hydrogeologger/hardware-datalogger/README.md

# Datalogger Version 3.X

Project was developed in Altium.

### Physical Dimensions (Max)
* Primary: 24cm x 18cm
* Secondary: 24cm x 13cm
