hydrogeologger/hardware-datalogger/doc/rpi-bpim2zero-pinout.xlsx

 | BPI M2 Zero |  | RPI |  |  |  | RPI |  | BPI M2 Zero
Usage |  | GPIO | GPIO/BCM | Desc | Physical Pin |  | Desc | GPIO/BCM | GPIO |  | Usage
 | 3v3 |  | 3v3 |  | 1 | 2 | 5v |  | 5v
GPIO | TWI0-SDA | PA12 | 2 | I2C1 SDA | 3 | 4 | 5v |  | 5v
GPIO | TWI0-SCK | PA11 | 3 | I2C1 SCL | 5 | 6 | GND |  | GND
Switch | PWM | PA6 | 4 | GPCKL0 | 7 | 8 | UART0 (TX) | 14 | PA13 | UART3 (TX) | GPIO/TX
 | GND |  | GND |  | 9 | 10 | UART0 (RX) | 15 | PA14 | UART3 (RX) | GPIO/RX
GPIO | UART2 (RX) | PA1 | 17 |  | 11 | 12 |  | 18 | PA16 | UART3 (CTS) | GPIO
MCU Reset | UART2 (TX) | PA0 | 27 |  | 13 | 14 | GND |  | GND
Switch | UART2 (CTS) | PA3 | 22 |  | 15 | 16 |  | 23 | PA15 | UART3 (RTS) | Switch
 | 3v3 |  | 3v3 |  | 17 | 18 |  | 24 | PC4 |  | Switch
GPIO | SPI0 (MOSI) | PC0 | 10 | SPI0 MOSI | 19 | 20 | GND |  | GND
GPIO | SPI0 (MISO) | PC1 | 9 | SPI0 MISO | 21 | 22 |  | 25 | PA2 | UART2 (RTS) | Switch
GPIO | SPI0-CLK | PC2 | 11 | SPI0 SCLK | 23 | 24 | SPI0 CE0 | 8 | PC3 | SPI0-CS | GPIO
 | GND |  | GND |  | 25 | 26 | SPI0 CE1 | 7 | PC7 |  | GPIO
-- | TWI1-SDA | PA19 | 0 | EEPROM SDA | 27 | 28 | EEPROM SCL | 1 | PA18 | TWI1-SCK | --
Switch |  | PA7 | 5 |  | 29 | 30 | GND |  | GND
Switch |  | PA8 | 6 |  | 31 | 32 | PWM0 | 12 | PL2-S-EINT2 |  | GPIO
GPIO/SOFT Rx |  | PA9 | 13 | PWM1 | 33 | 34 | GND |  | GND
GPIO |  | PA10 | 19 | PCM FS | 35 | 36 |  | 16 | PL4 |  | GPIO/SOFT Tx
Switch |  | PA17 | 26 |  | 37 | 38 | PCM DIN | 20 | PA21 |  | GPIO
 | GND |  | GND |  | 39 | 40 | PCM DOUT | 21 | PA20 |  | GPIO
