hydrogeologger/hardware-datalogger/Support/Phoenix Plug Cost.xlsx

1869279 8 way phoenix 5.08 pitch angled SMKDSN |  |  | 7.6/6.6
5mm Pitch (14 AWG) | Mouser ($AUD, 50 pack, per unit) | Digikey ($AUD, 50 pack, per unit price) | RS ($AUD, 50 pack, per unit price)
1721029 - 2-Position-2L
1703895 - 4-Position-2L
5.08mm Pitch (14 AWG)
1721728 - 2-Position-2L
1889987 - 4-Position-2L
1870909 - 8-Position-2L
MKKDSN 5.08 Pitch 1.5mm wire cross
1726040 - 2 pos
1726163 - 4 Pos
1726176 - 5 Pos
1726189 - 6 Pos
1726202 - 8 Pos
1870271 - 10 Pos
1729597 - 12 Pos
