hydrogeologger/hardware-datalogger/Schematic.pdf

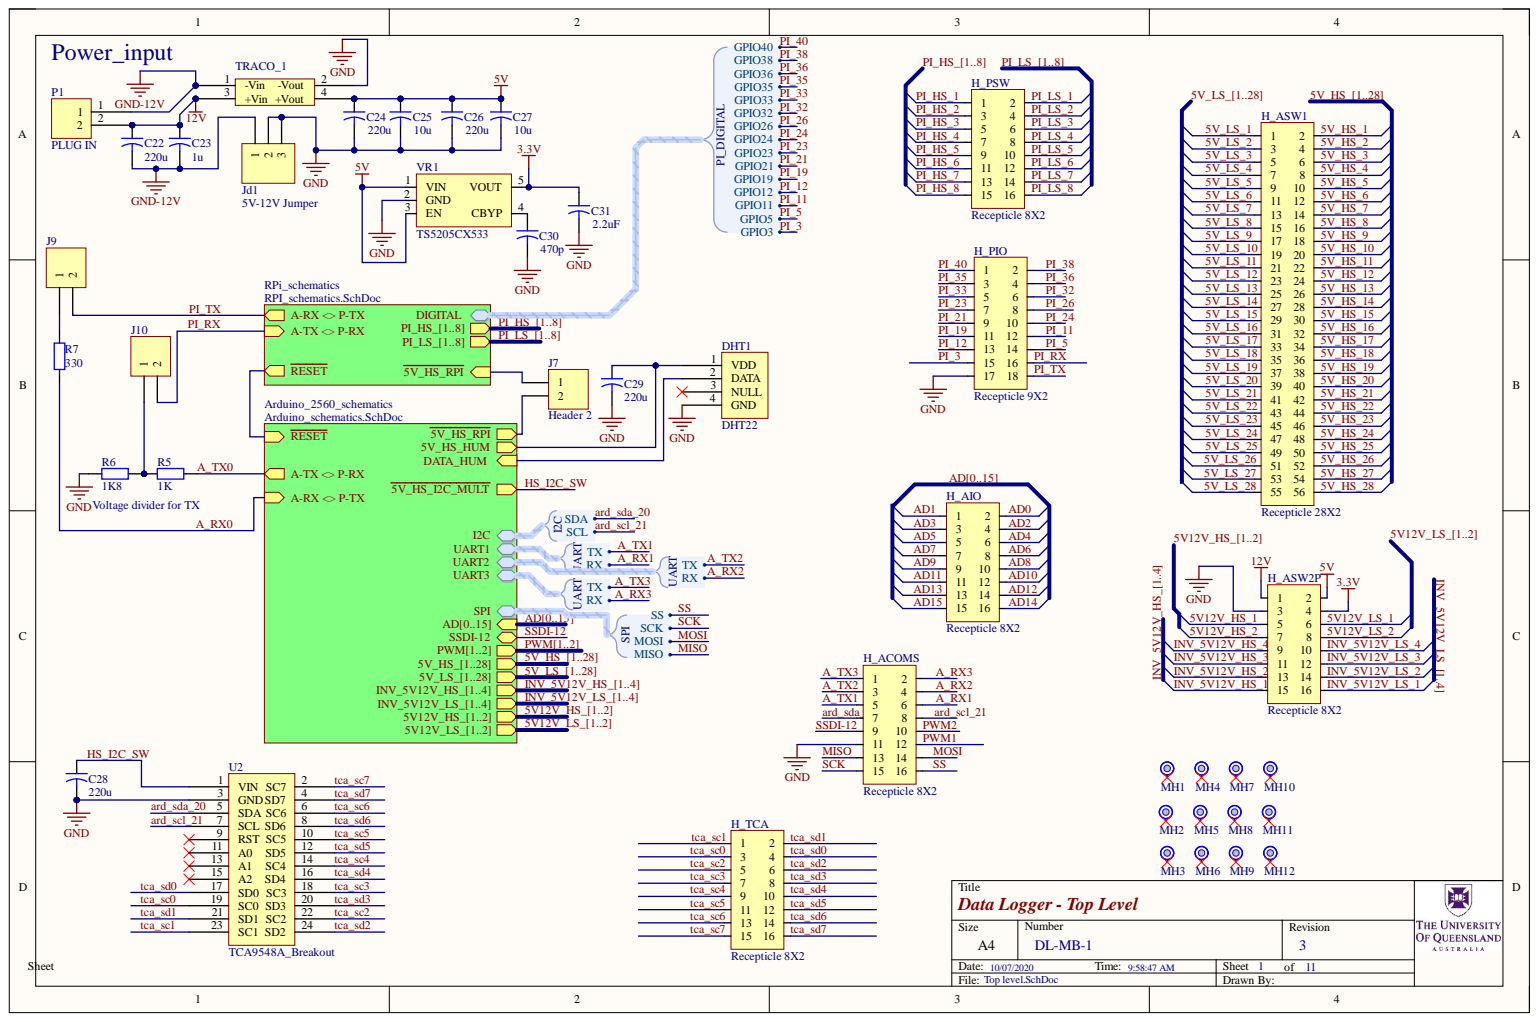
[picture p1: page 1]

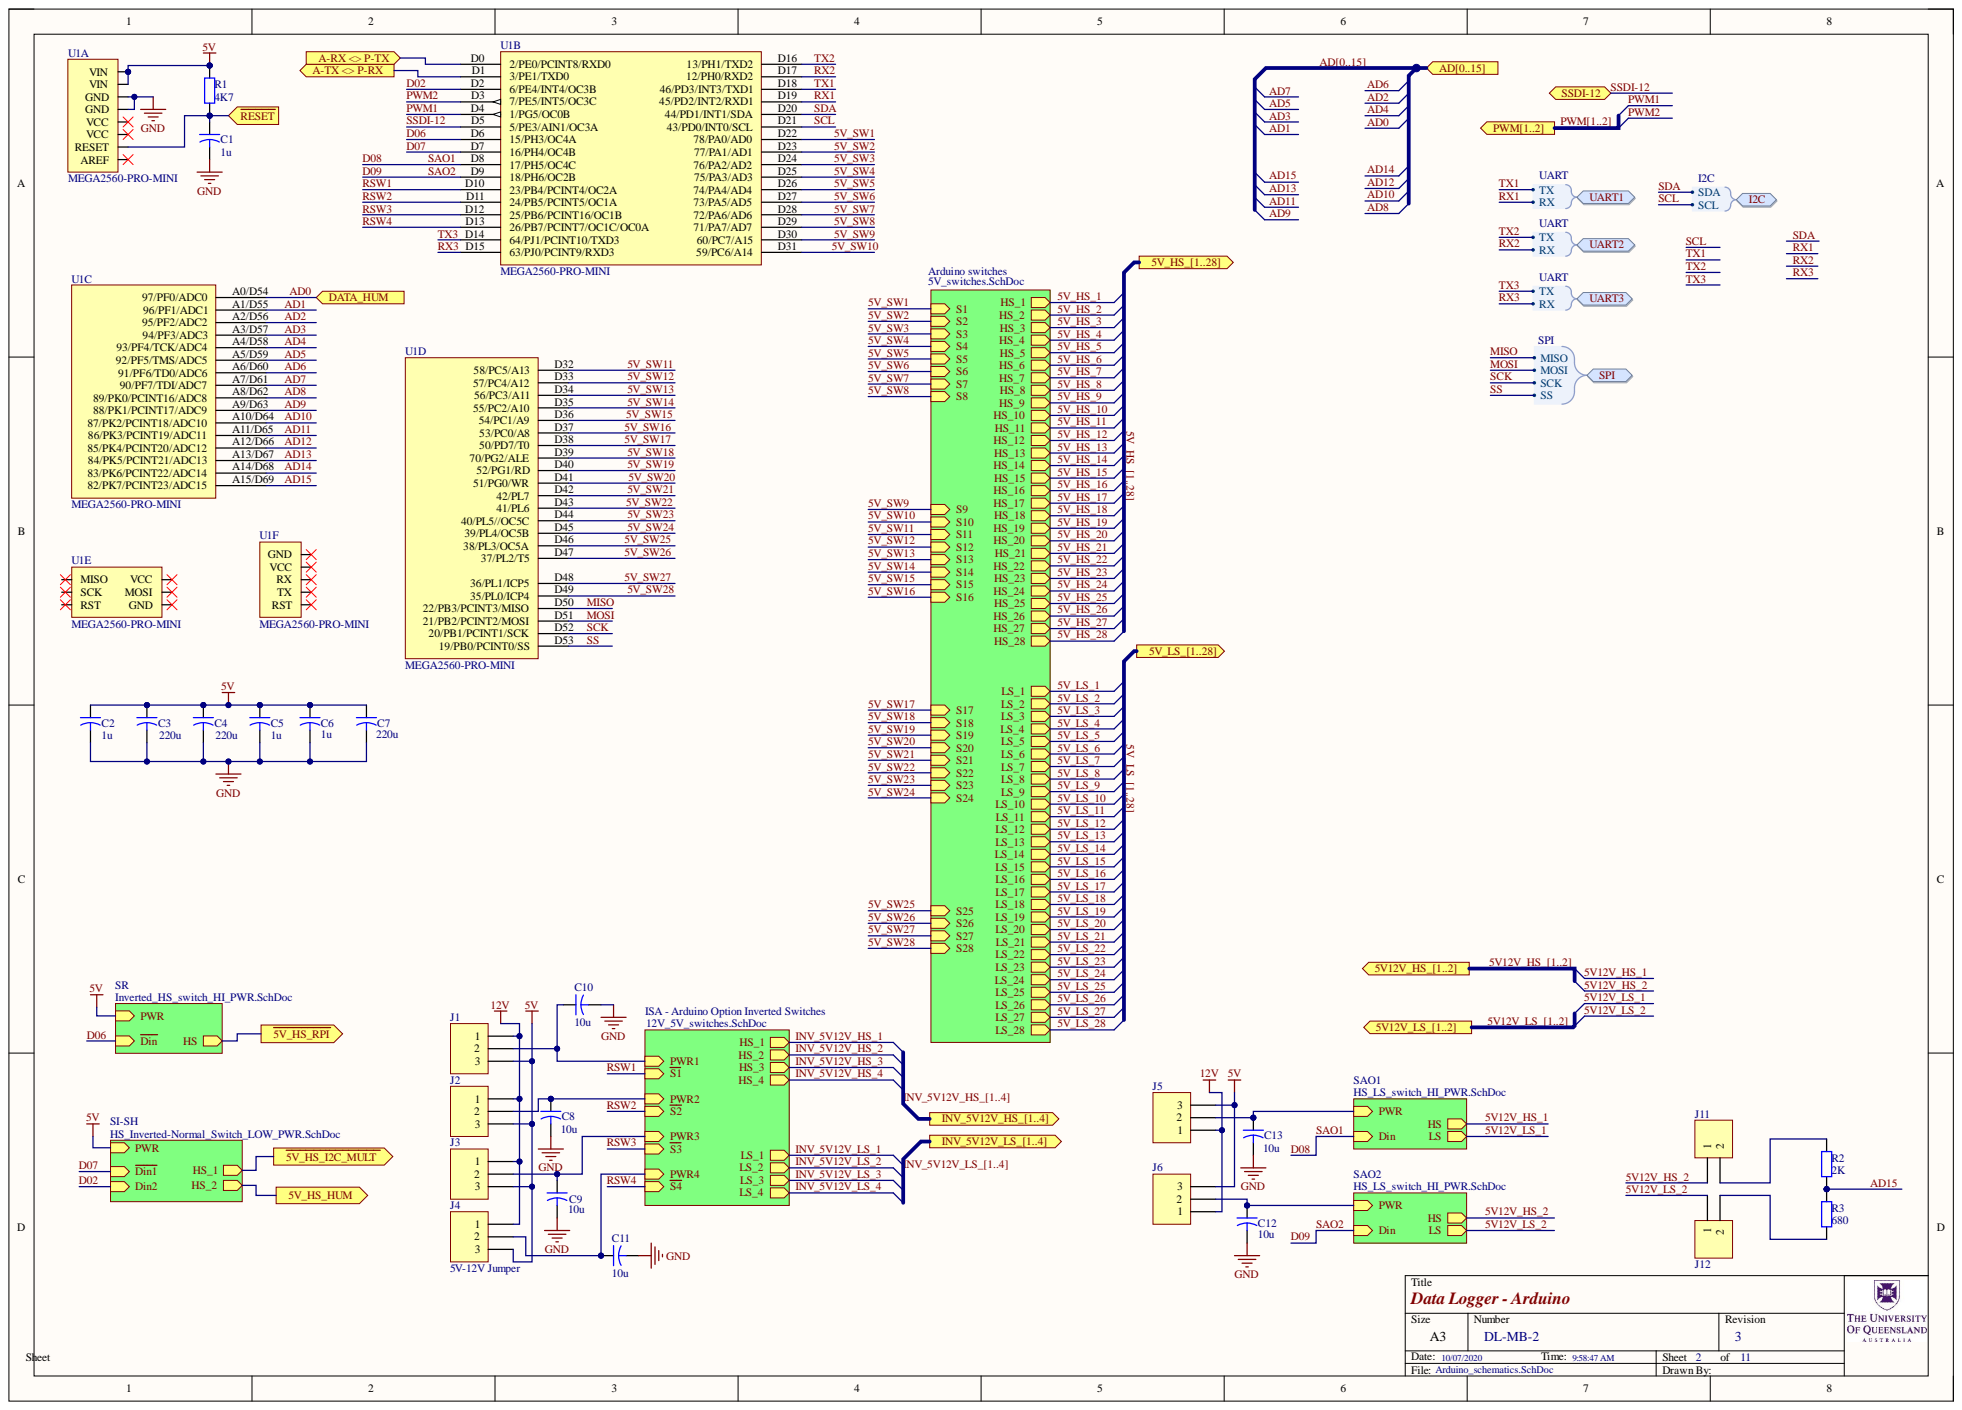
[picture p2: page 2]

Si z e | N umber D L-MB-2 | Revi s ion

Date: 10/07/2020 Ti me: 9:58:47 AM | of

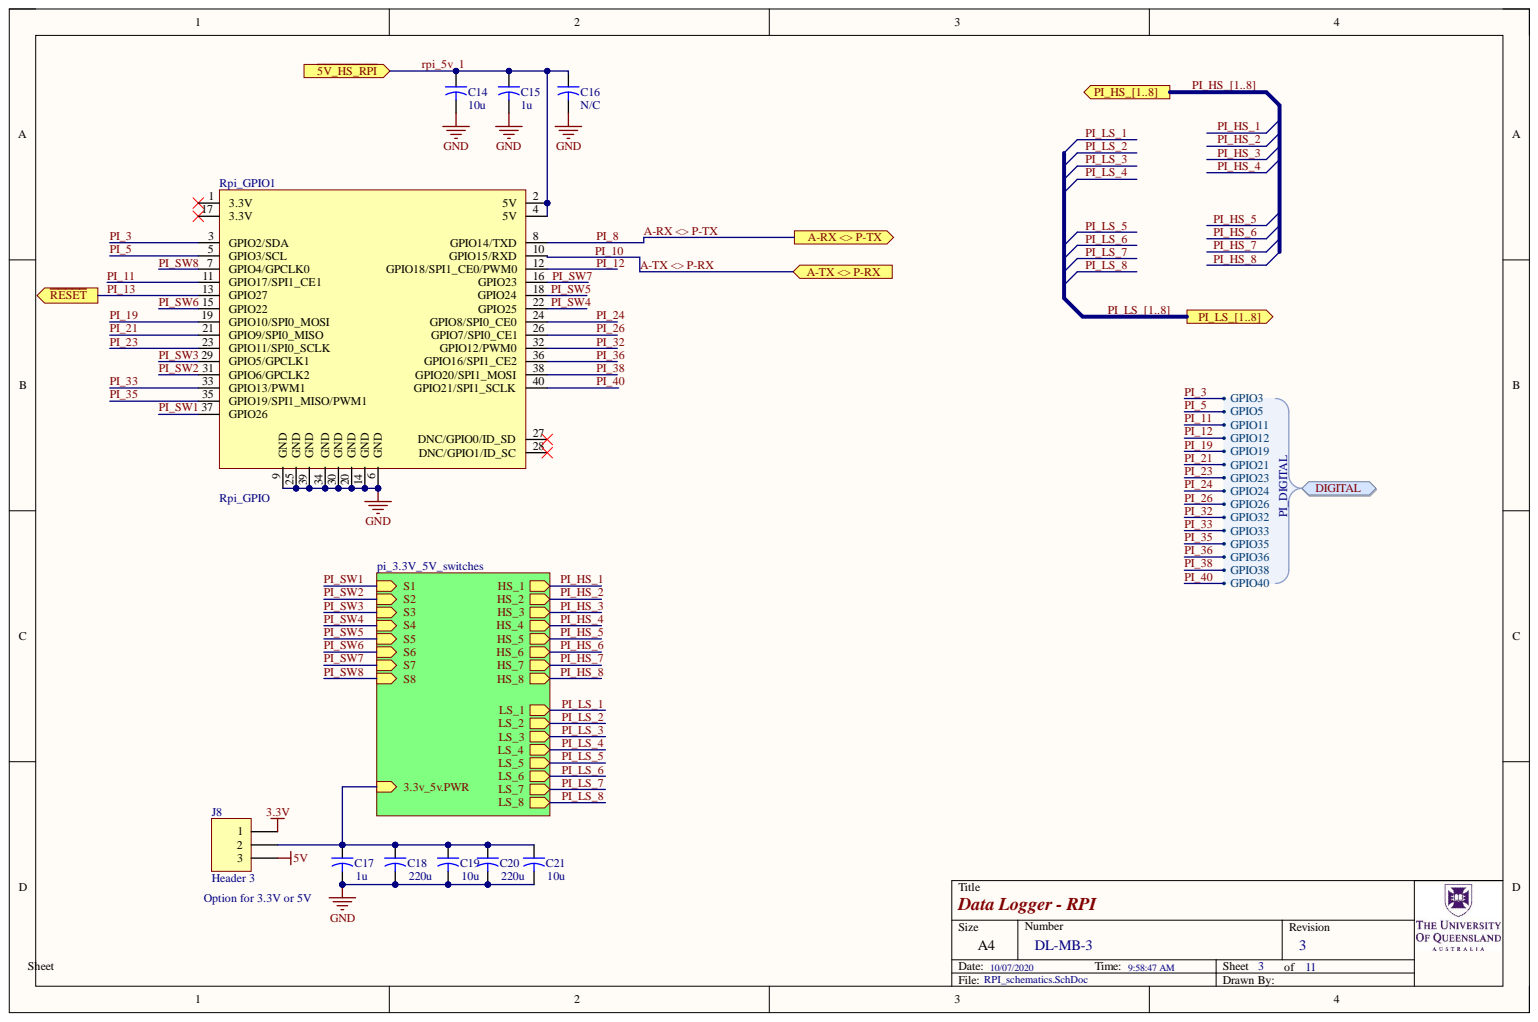
[picture p3: page 3]

Size A4 | Number DL-MB-3 | Revision 3

10/07/2020 Time: 9:58:47 AM

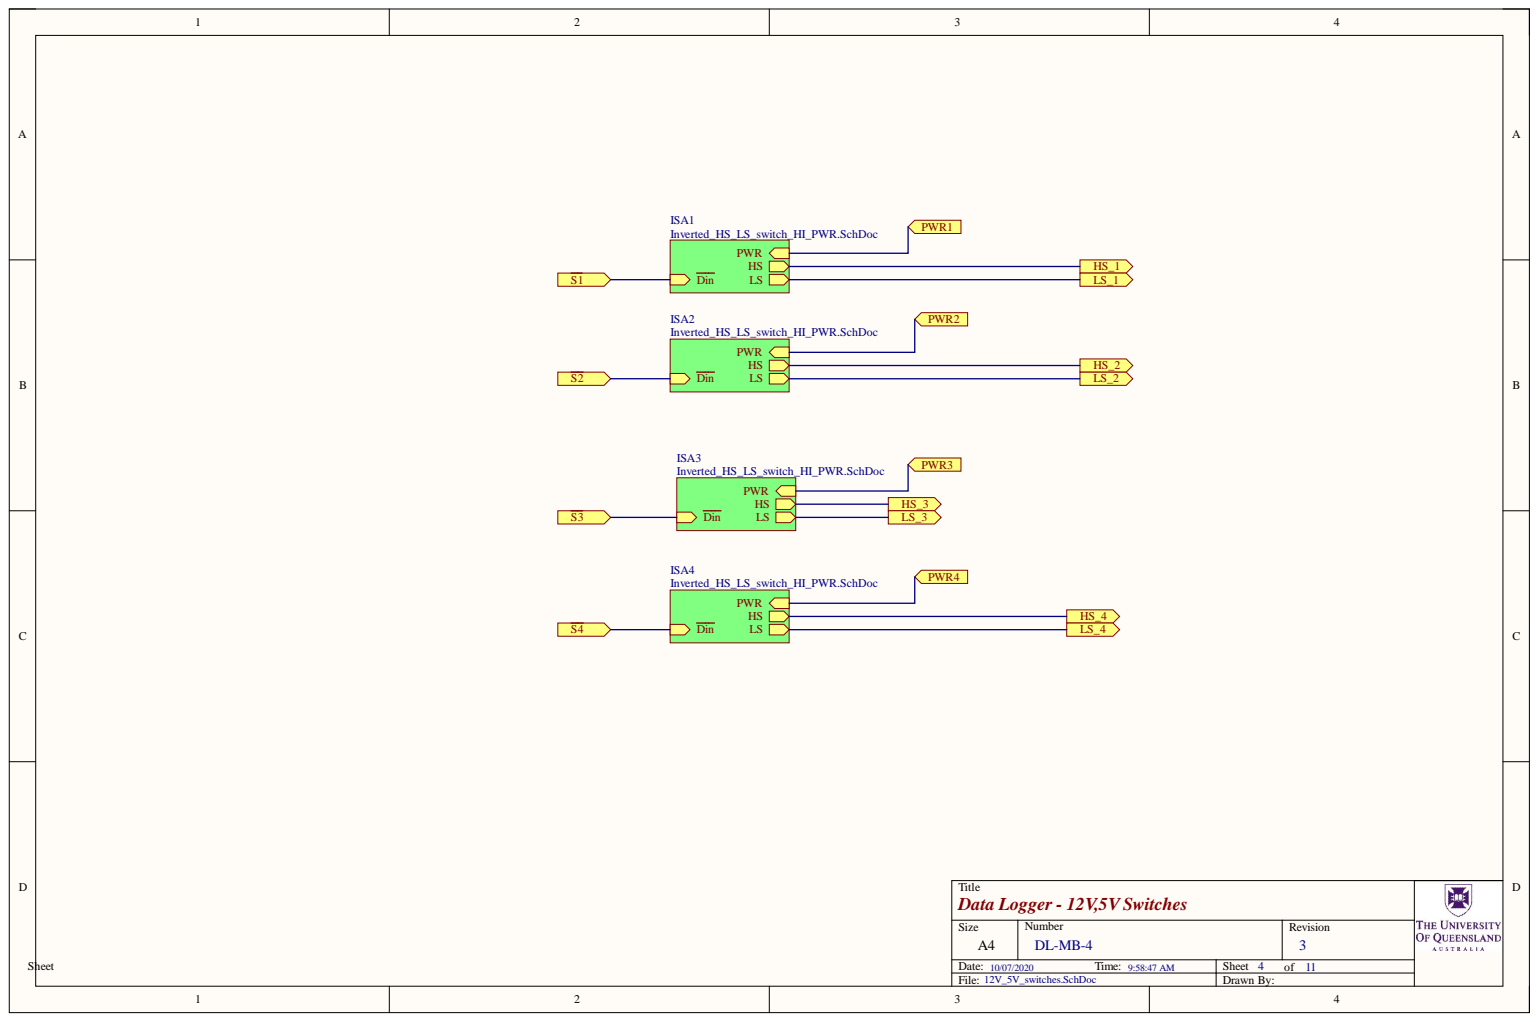
[picture p4: page 4]

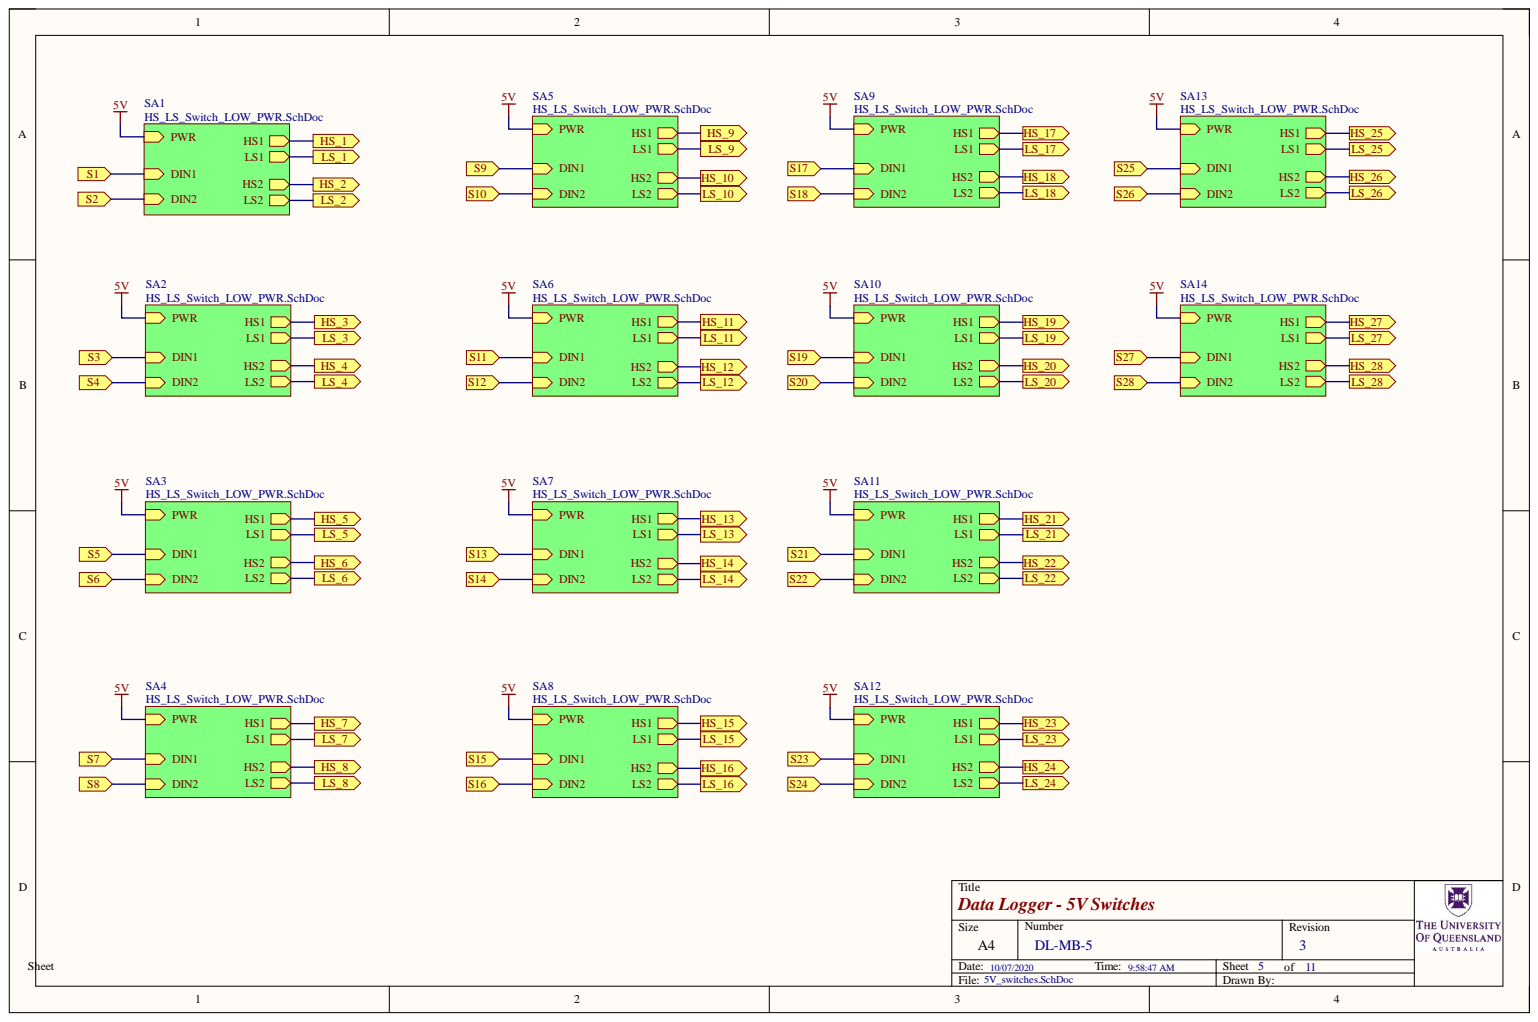
[picture p5: page 5]

Size A 4 | N u mber DL-MB-5 | Rev i s i o n 3

Date: 10/07/202 0 Ti me: 9:58:47 AM | t o f

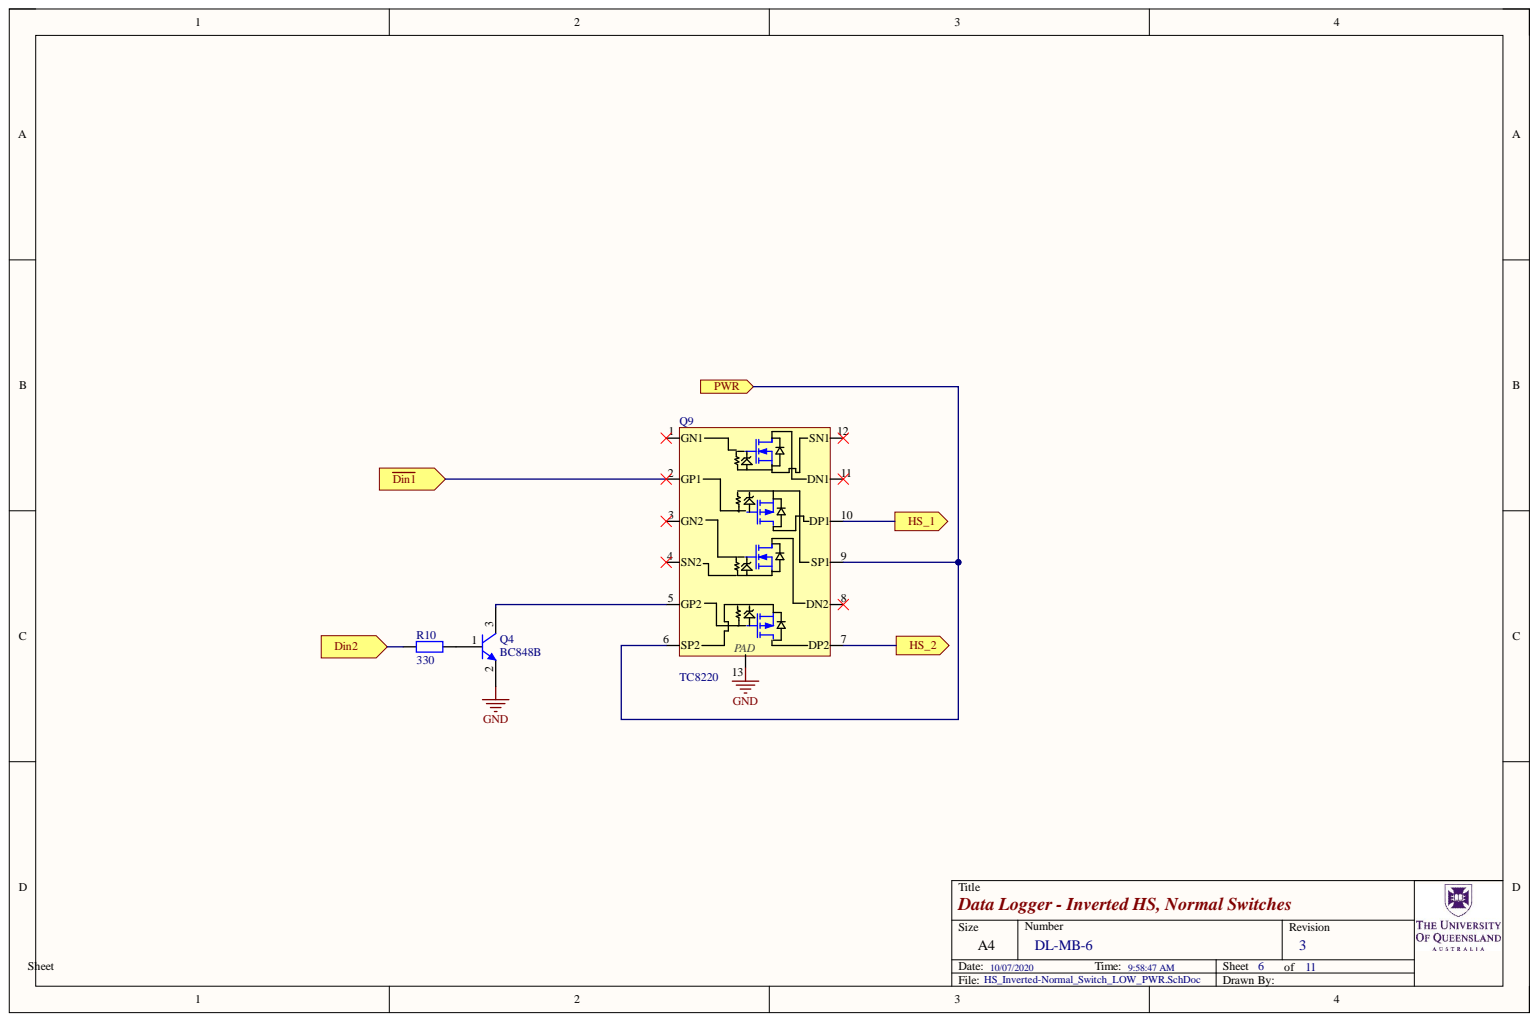
[picture p6: page 6]

Title
Data Logger - Inverted HS, Normal Switches

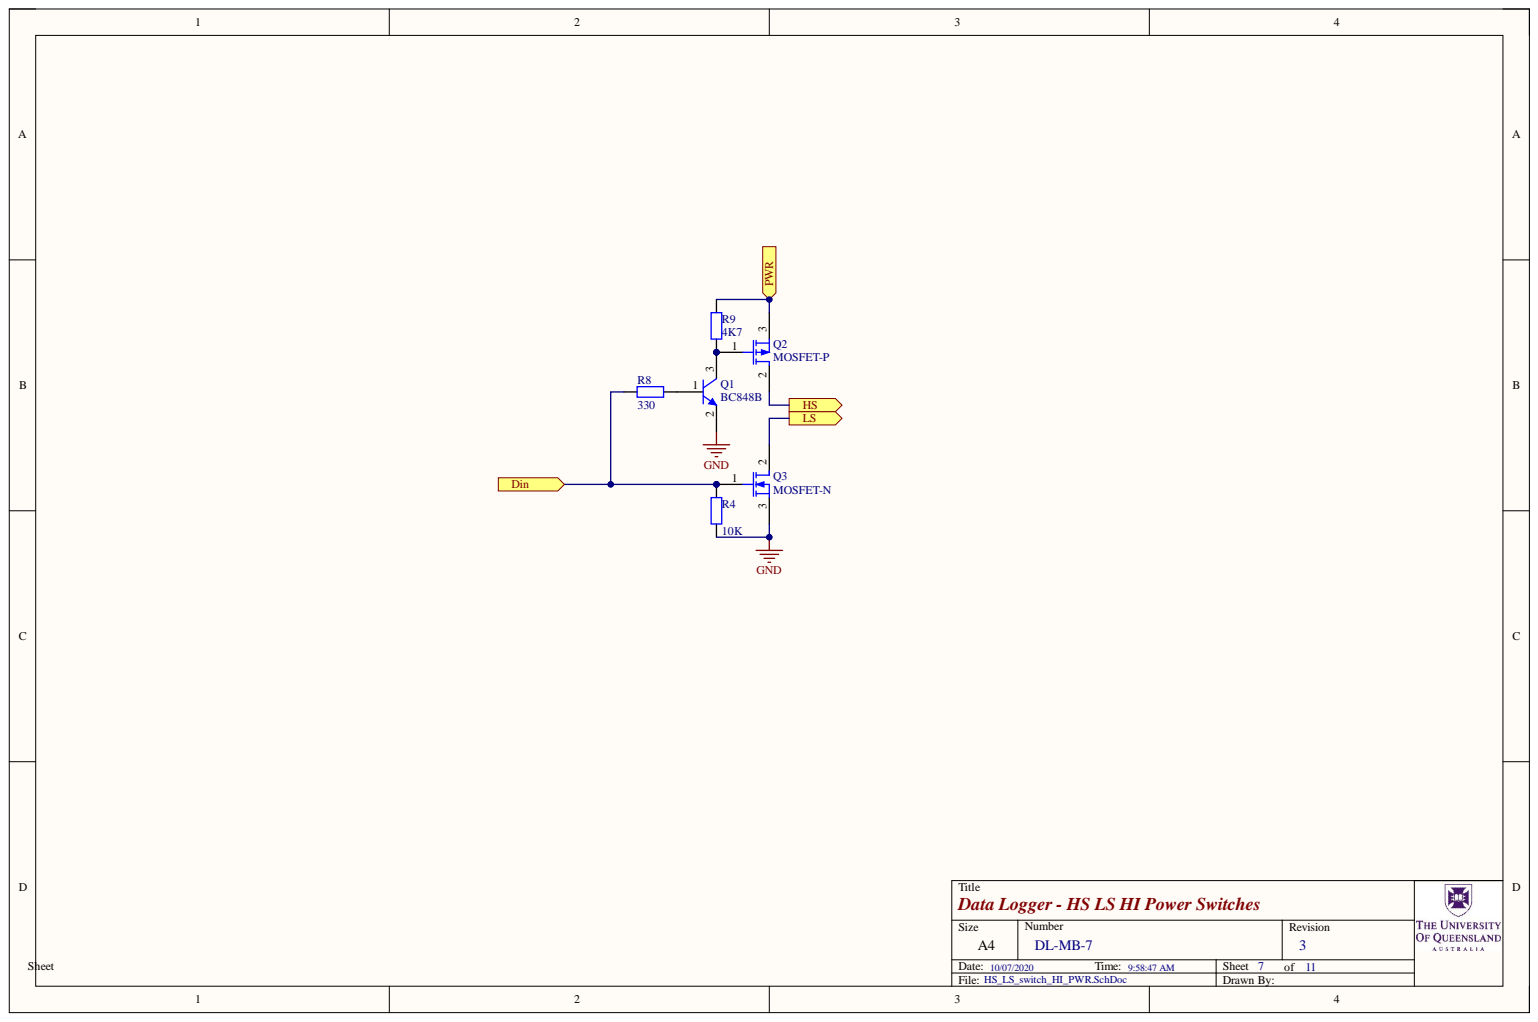
[picture p7: page 7]

Title
Data Logger - HS LS HI Power Switches

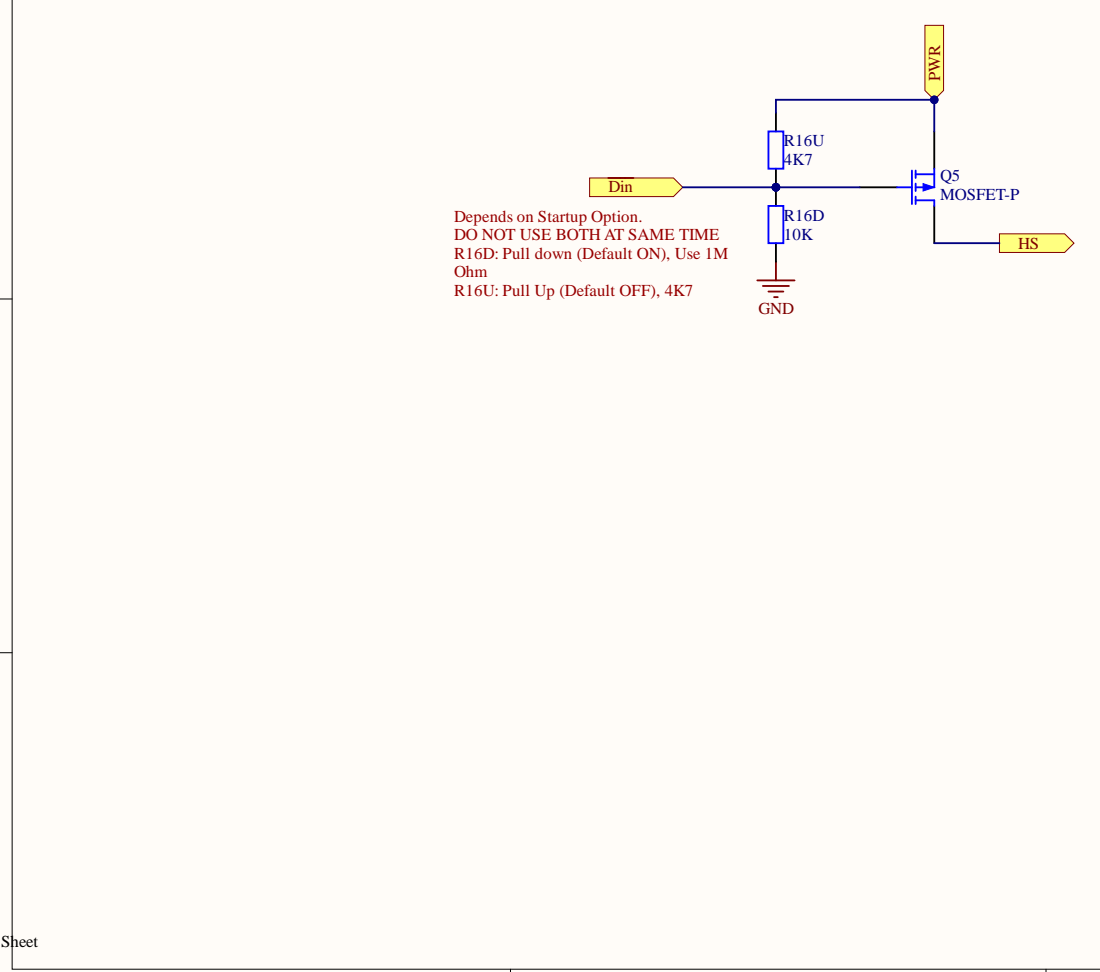
[picture p8: page 8]

gger - Inverted HS Hi Power Switch

Size A 4 | N u mber DL-MB-8 | Rev i s i o n 3

Date: 10/07/202 0 Ti me: 9:58:47 AM | t o f

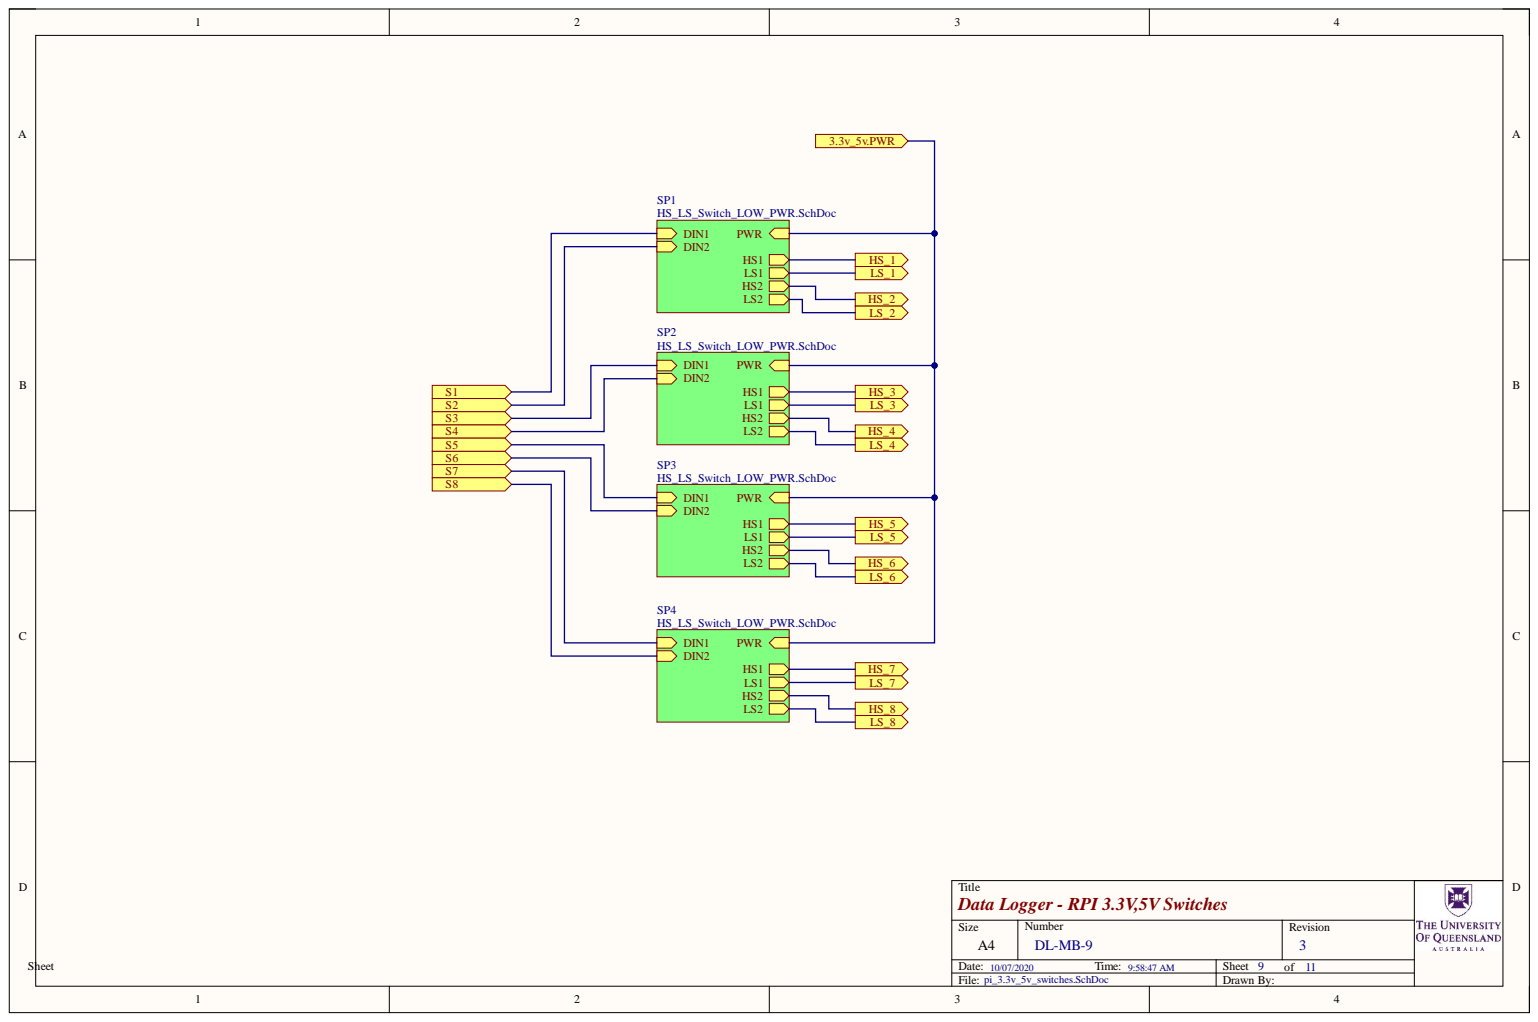
[picture p9: page 9]

Title
Data Logger - RPI 3.3V,5V Switches

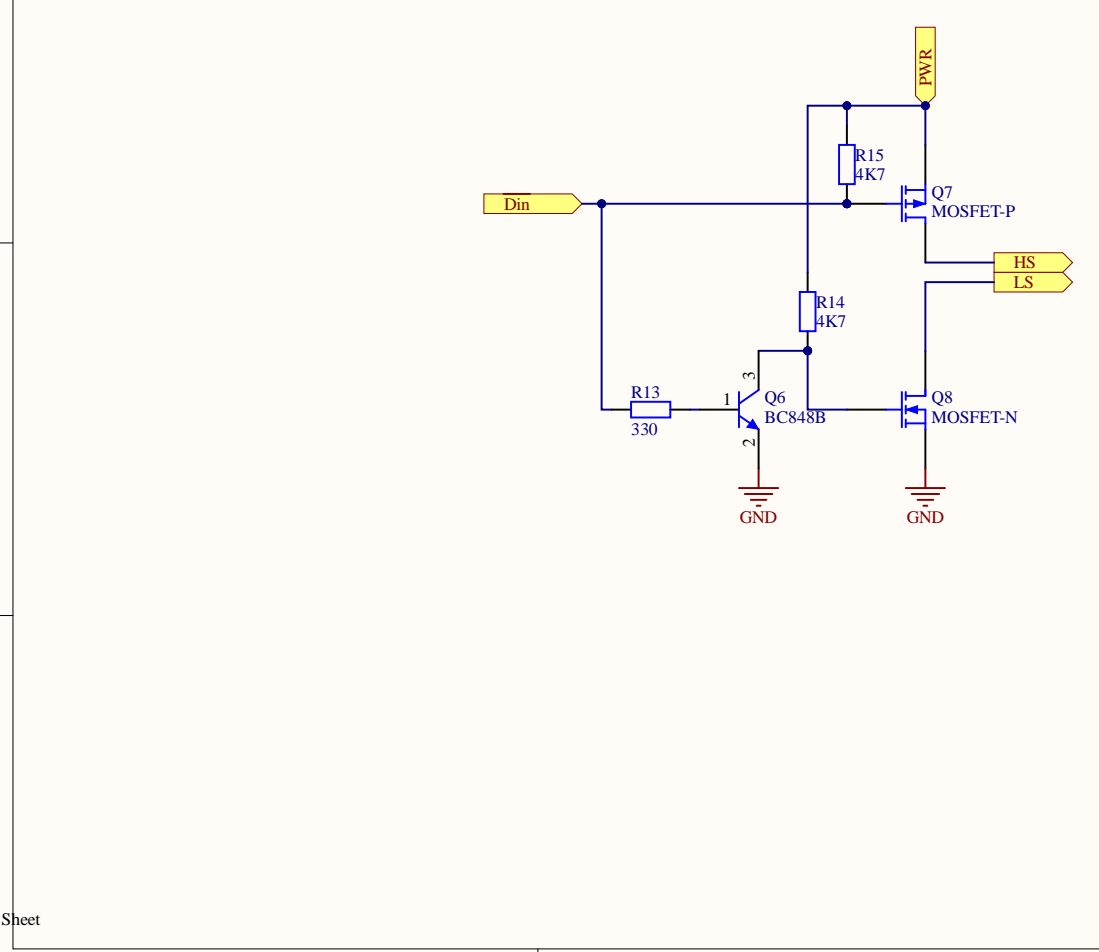
[picture p10: page 10]

Title
Data Logger - Inverted HS LS Hi Power Switches

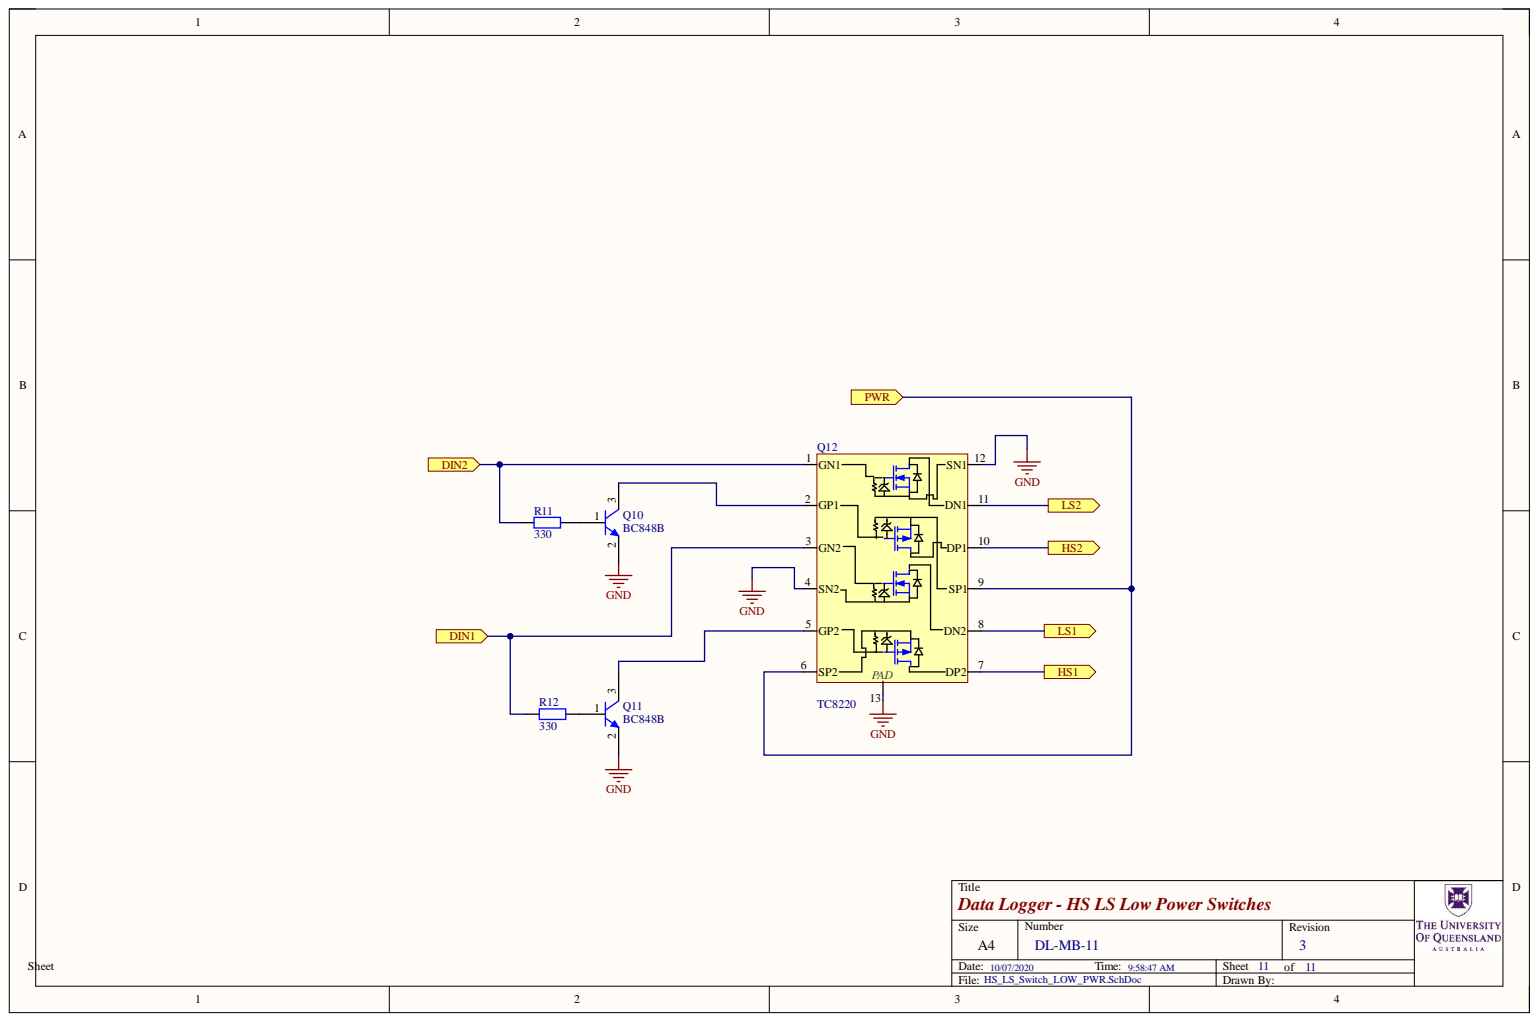
[picture p11: page 11]

Title
Data Logger - HS LS Low Power Switches
