hydrogeologger/hardware-datalogger/doc/schematic.pdf

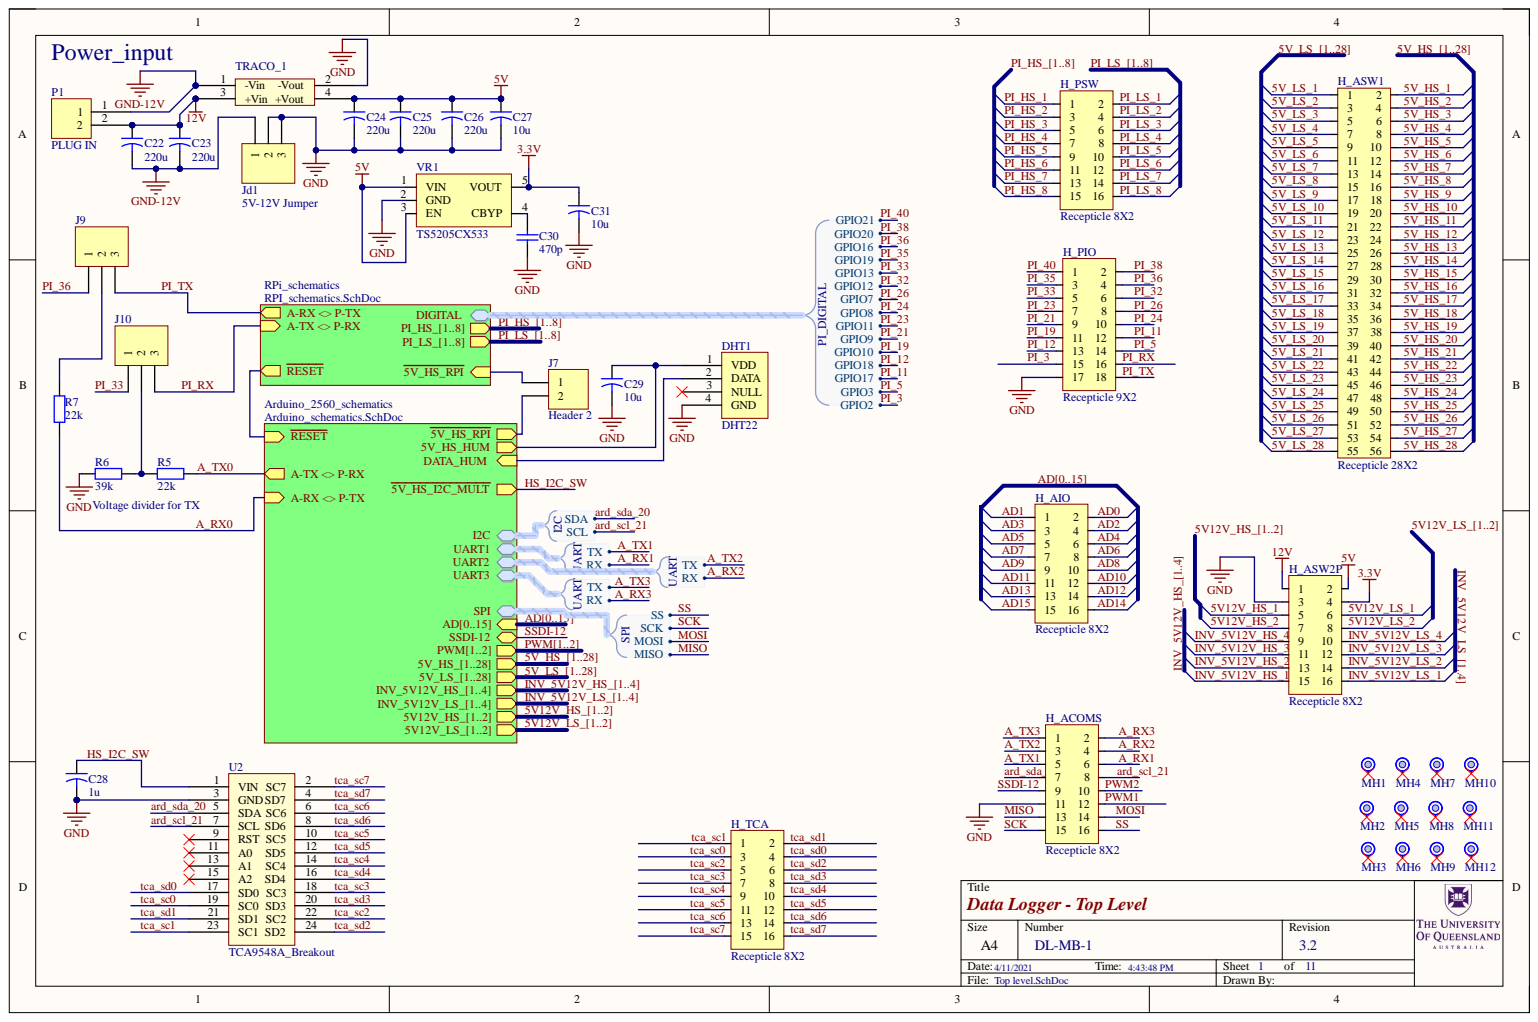
[picture p12: page 1]

5 V _ HS_RPI RESE T 5 V _ HS_ H U M D ATA_ H U M A-T X <> P-RX 5 _ HS_ I 2C_MU LT A-RX <> P-T X I 2 C U A RT 1 U A RT 2 U A RT 3 SPI A D[0..1 5 ] SSD I-1 2 PWM[1..2 ] V _ HS_[1..2 8 ] V _ LS_[1..2 8 ] IN V 2 V _ HS_[1..4 ] IN V 2 V _ LS_[1..4 ] 2 V _ HS_[1..2 ] 5 2 V _ LS_[1..2 ] | N N

1 u 3 | 4 tca_ s d 7

ard _ s da_ 2 0 5 | 6 tca_ s c 6

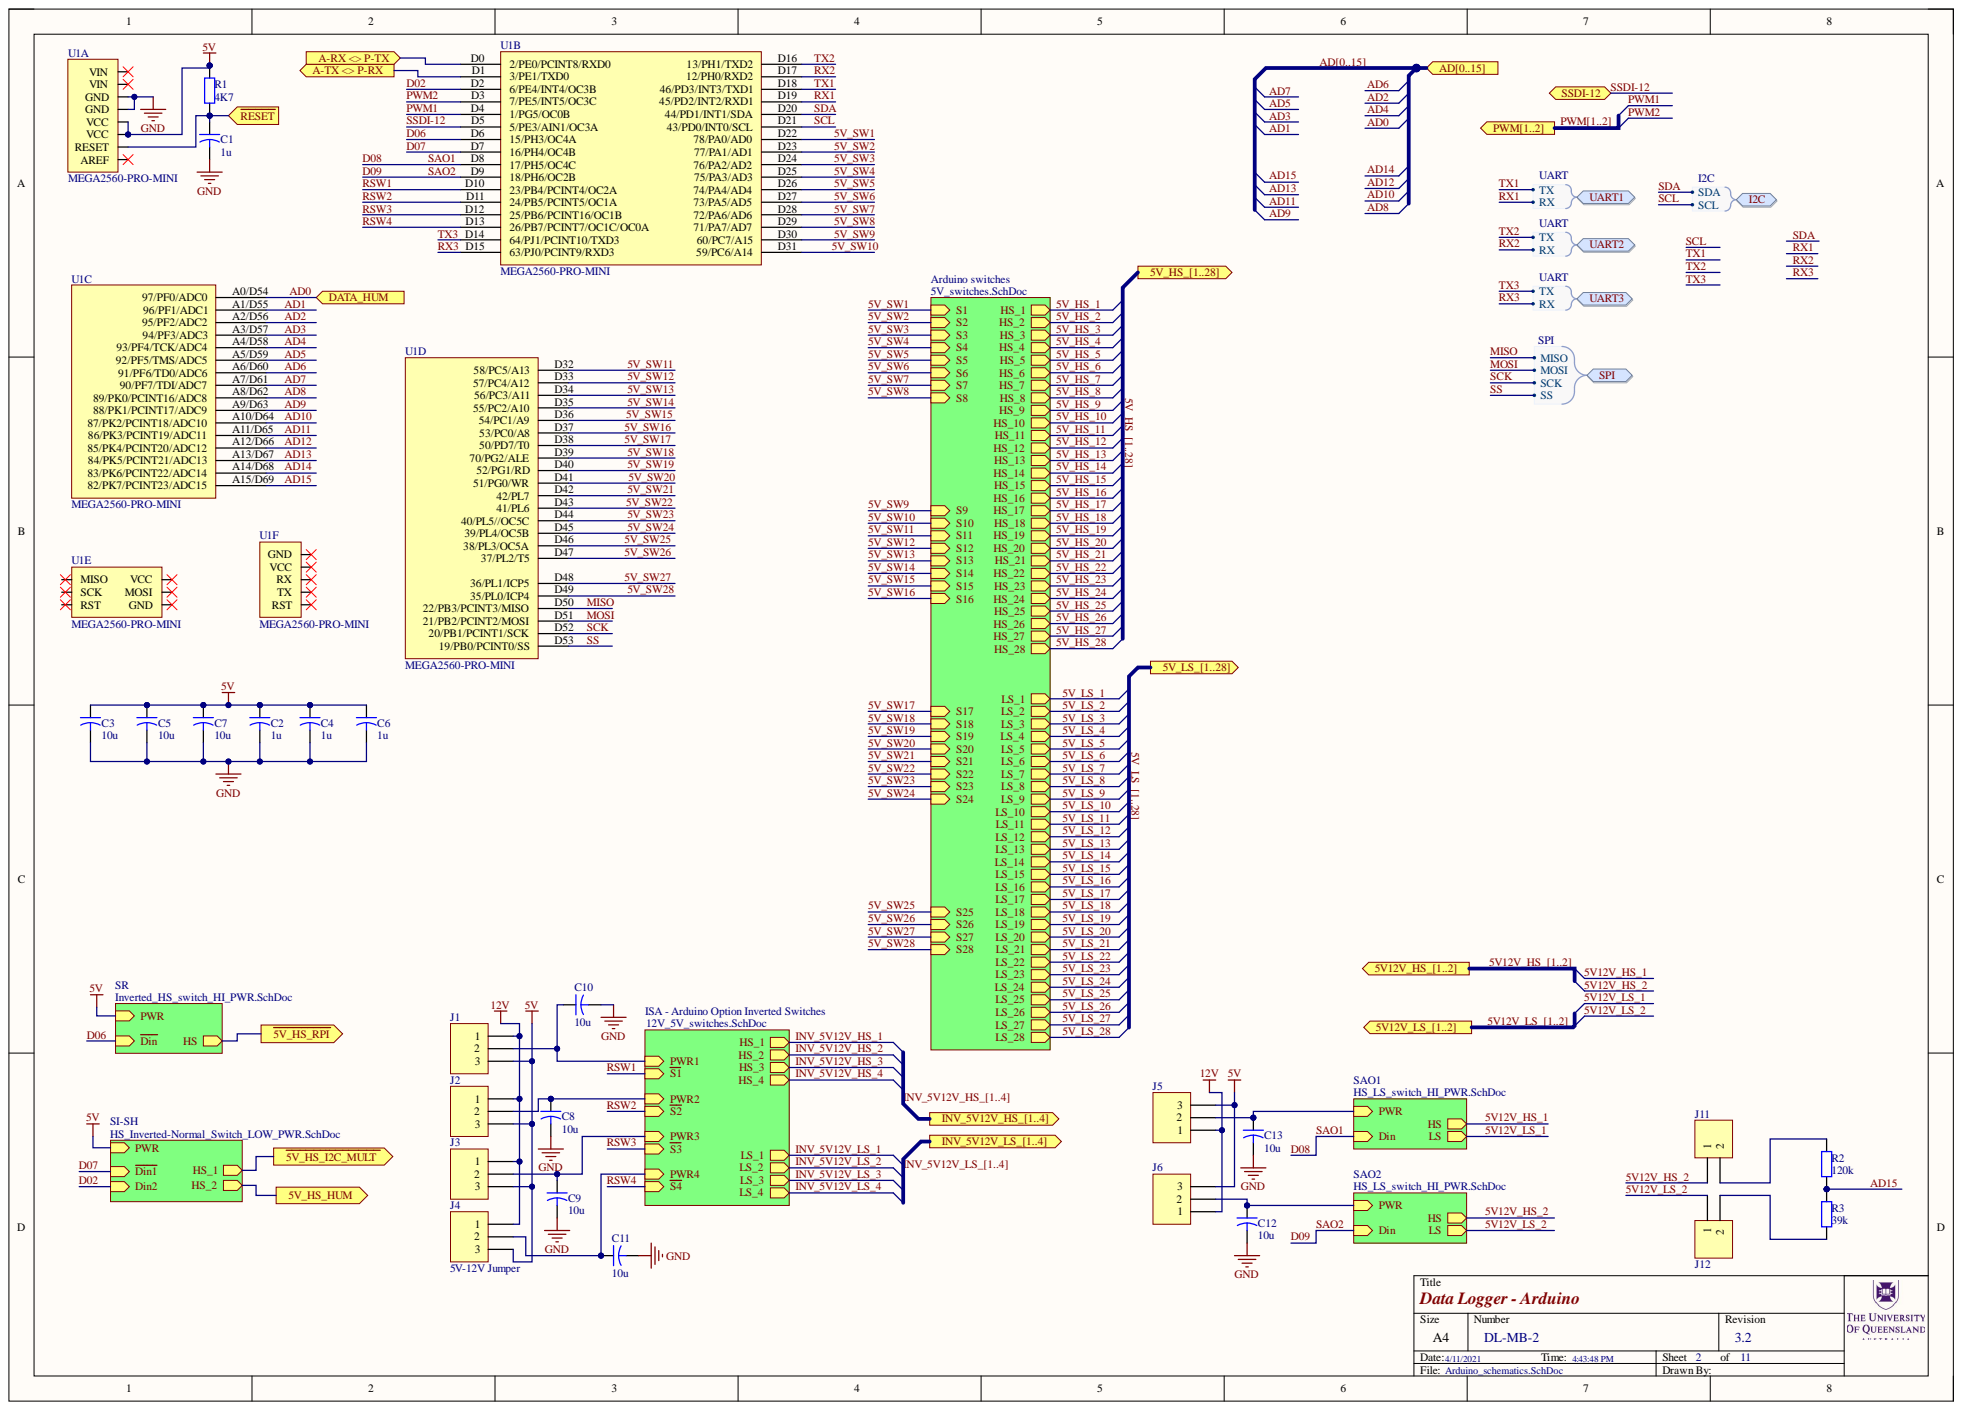
[picture p13: page 2]

Si z e A | N umber D L-MB-2 | Revi s ion 3.2

Date: 4/ 11/2021 4:43:48 PM | Sheet of

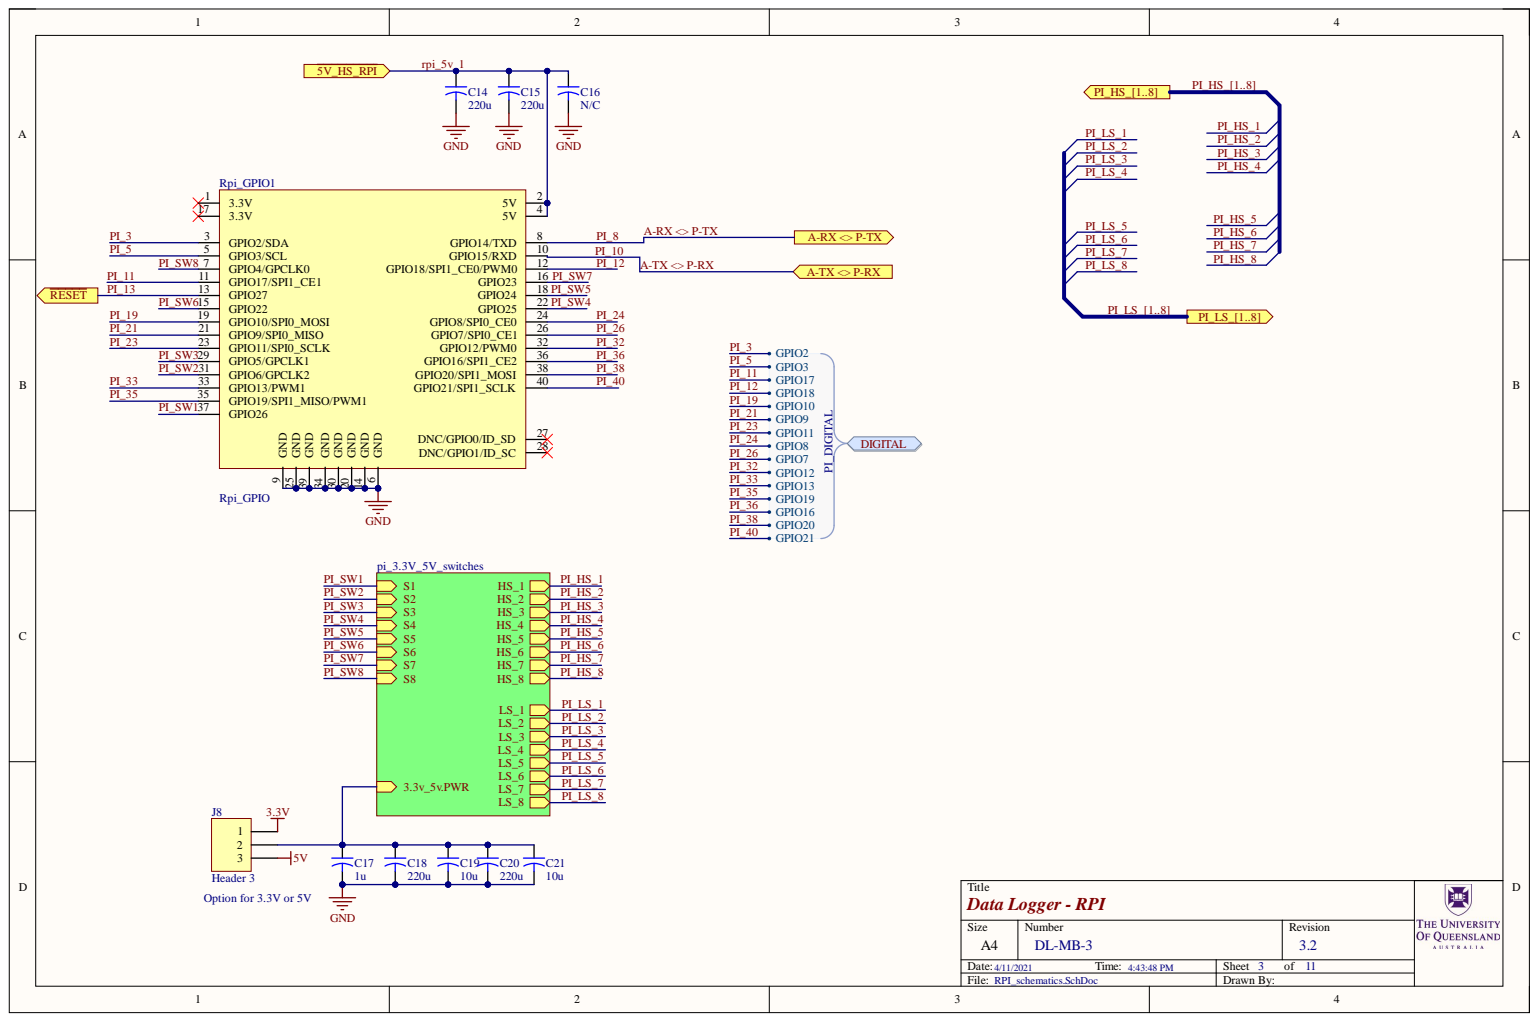
[picture p14: page 3]

Size A4 | Number DL-MB-3 | Revision 3.2

Date: 4/11/2021 Time: 4:43:48 PM | Sheet 3 of 11

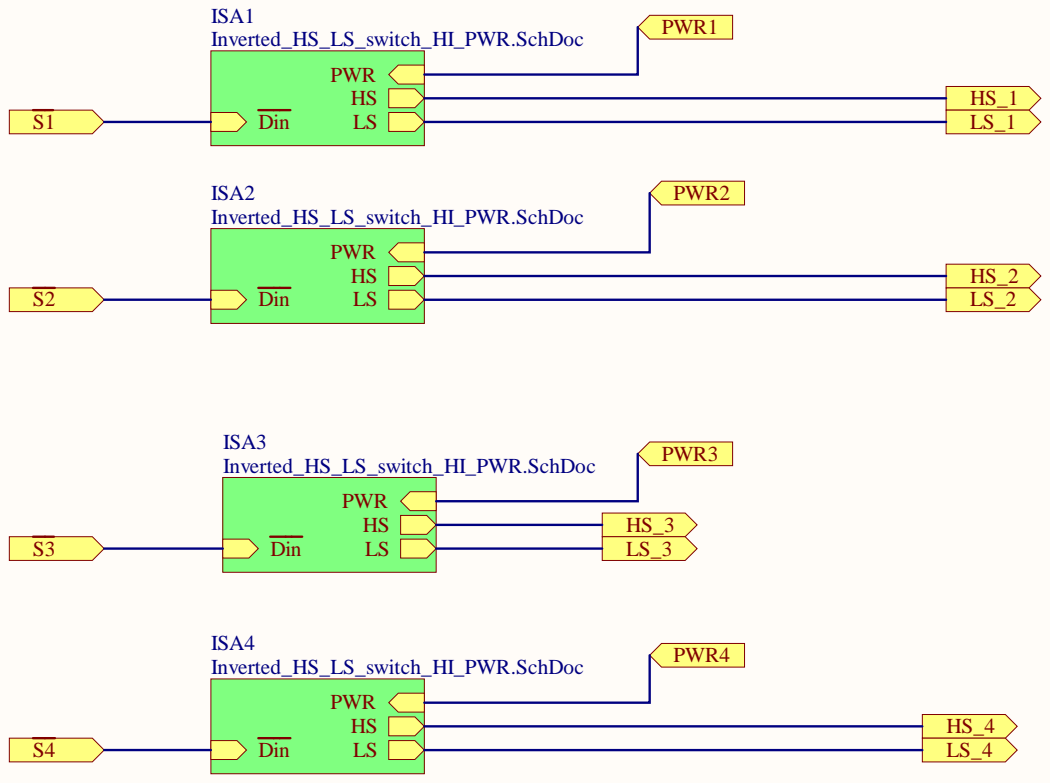
[picture p15: page 4]

Size A4 | Number DL-MB-4 | Revision 3.2

Date: 4/11/2021 Time: 4:43:48 PM | Sheet 4 of 11

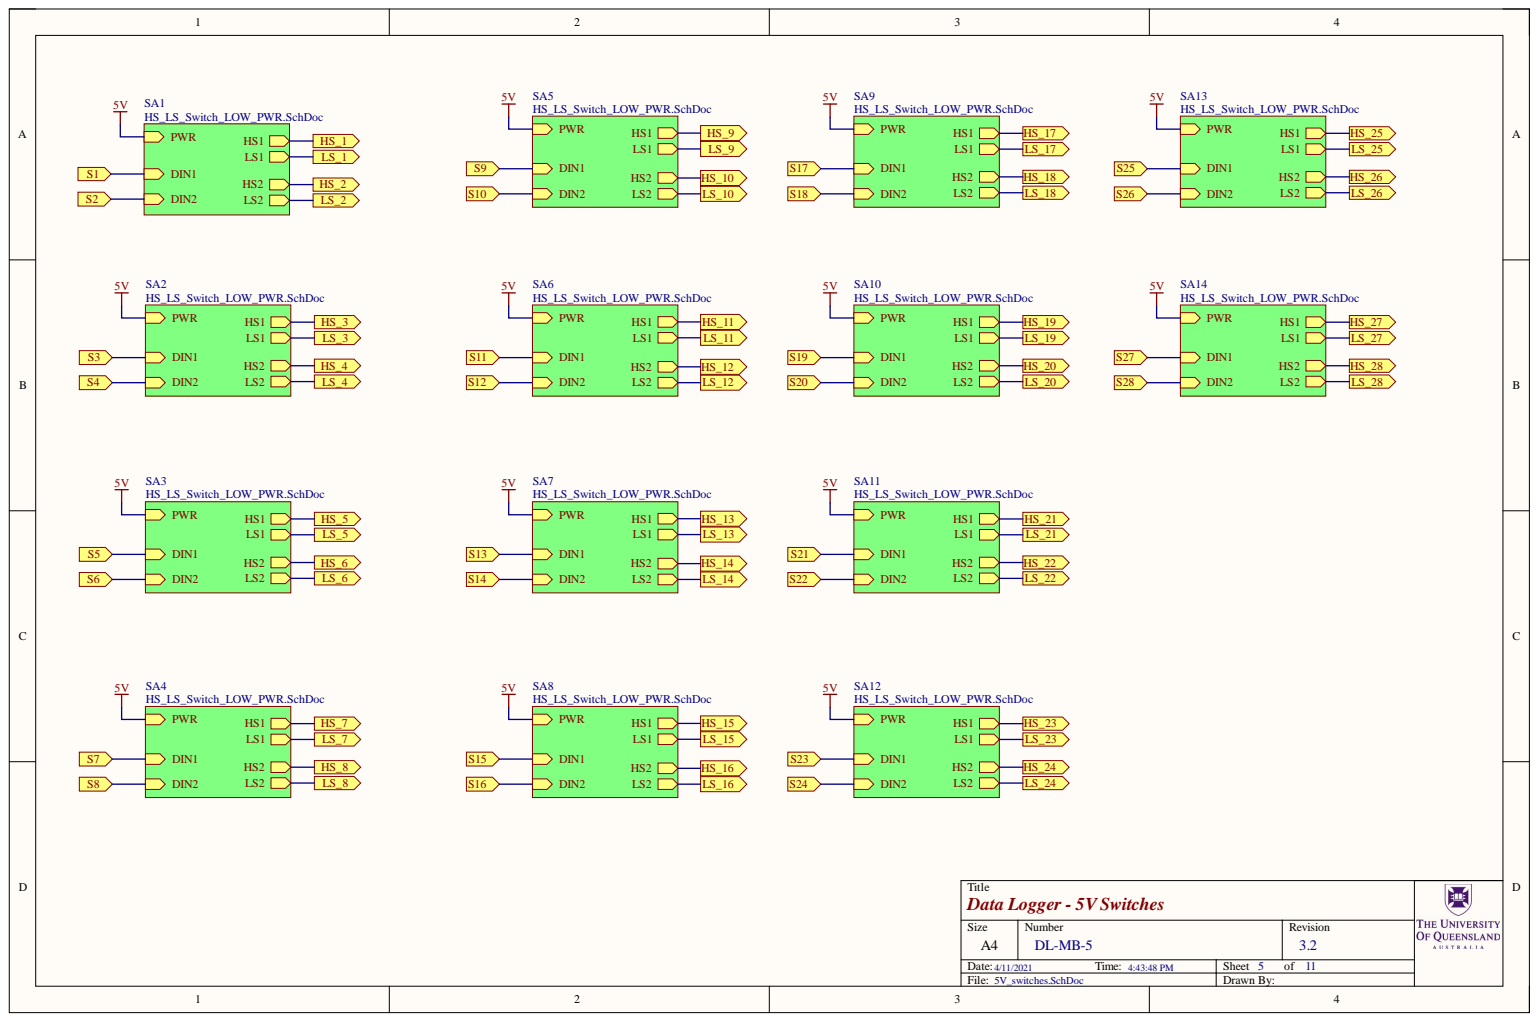
[picture p16: page 5]

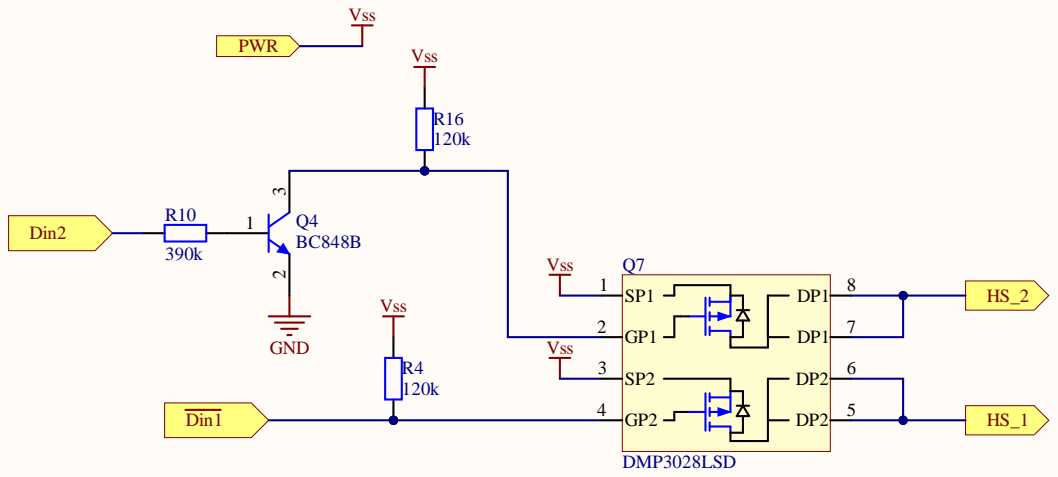
[picture p17: page 6]

gger - Inverted HS, Norm

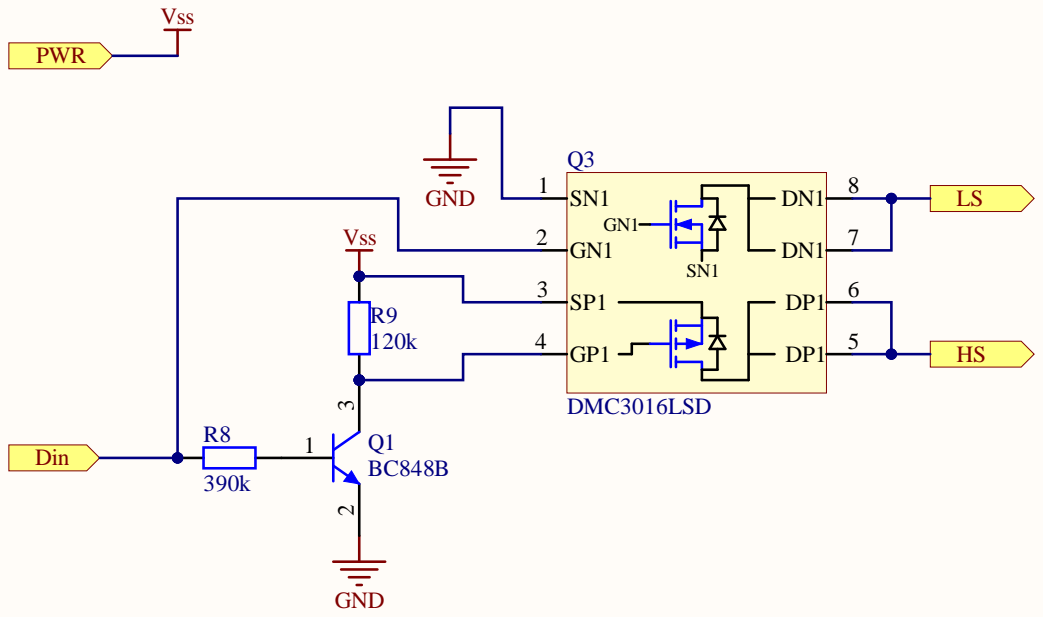
[picture p18: page 7]

gger - HS LS HI Power Switches

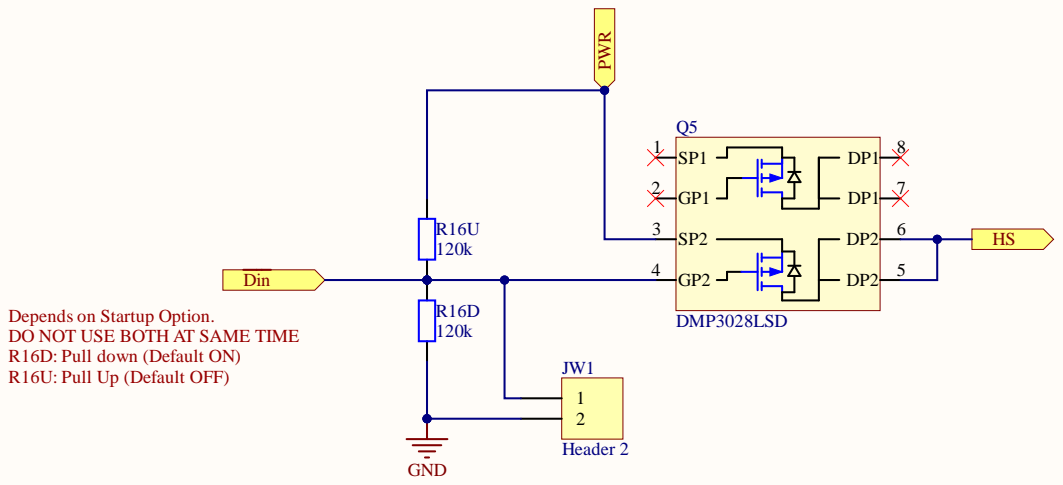
[picture p19: page 8]

gger - Inverted HS Hi Power Switch

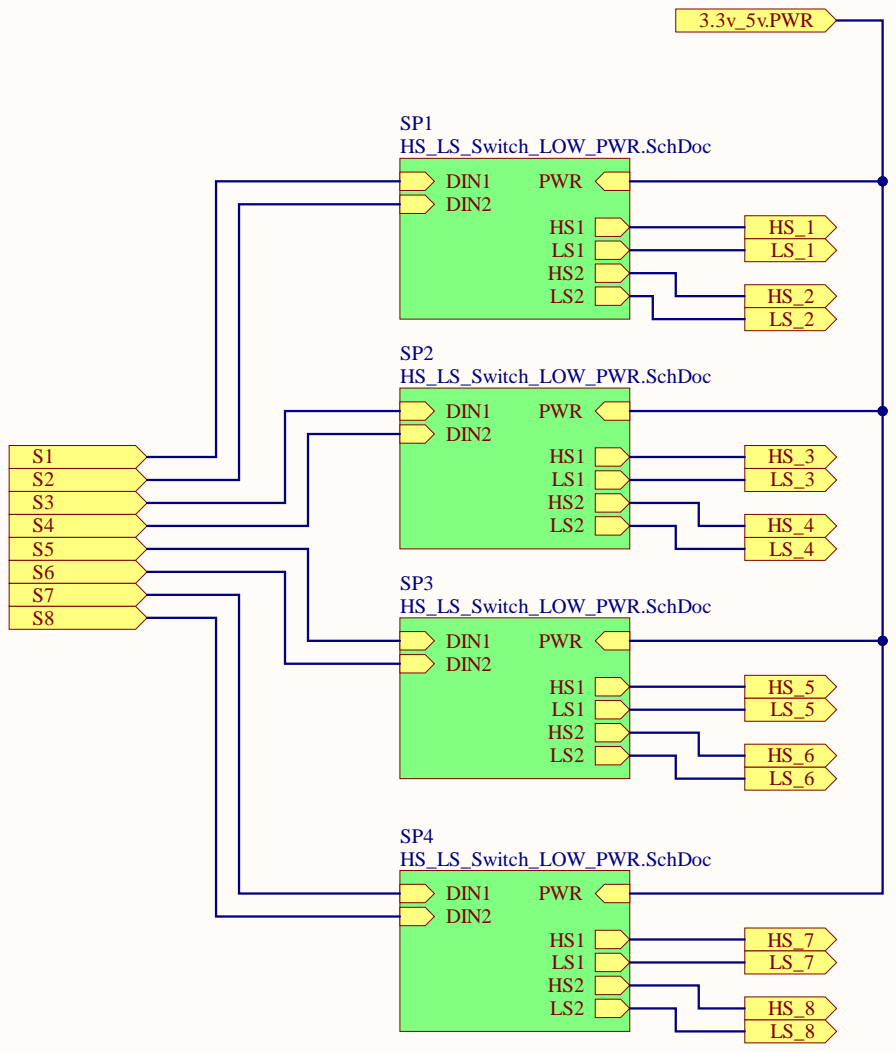
[picture p20: page 9]

Title
Data Logger - RPI 3.3V,5V Switches

Size A4 | Number DL-MB-9 | Revision 3.2

Date: 4/11/2021 Time: 4:43:48 PM | Sheet 9 of 11

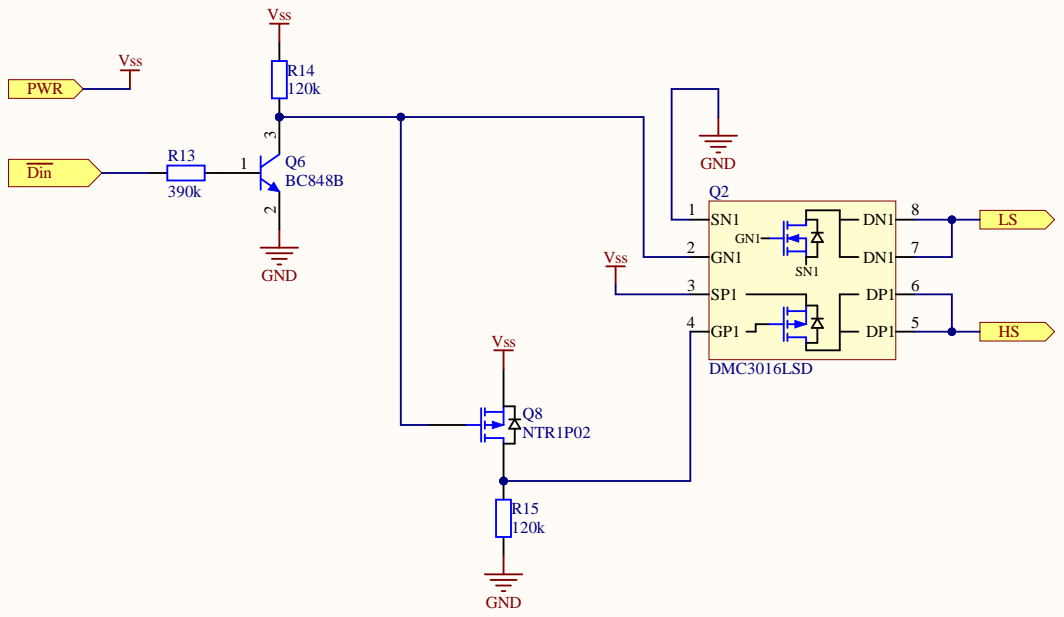
[picture p21: page 10]

gger - Inverted HS LS Hi Power Switches

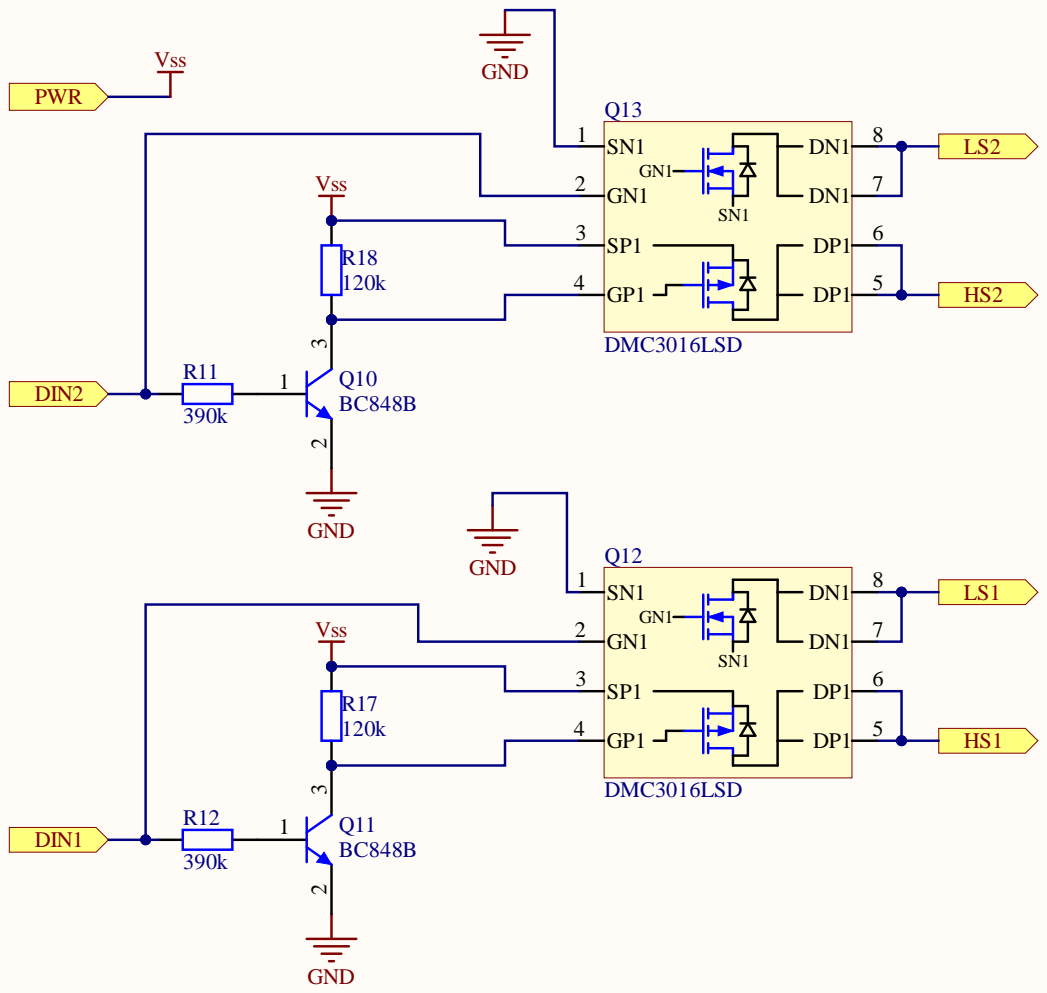
[picture p22: page 11]

gger - HS LS Low Power Switches
