hydrogeologger/hardware-datalogger/doc/boardoutline.pdf

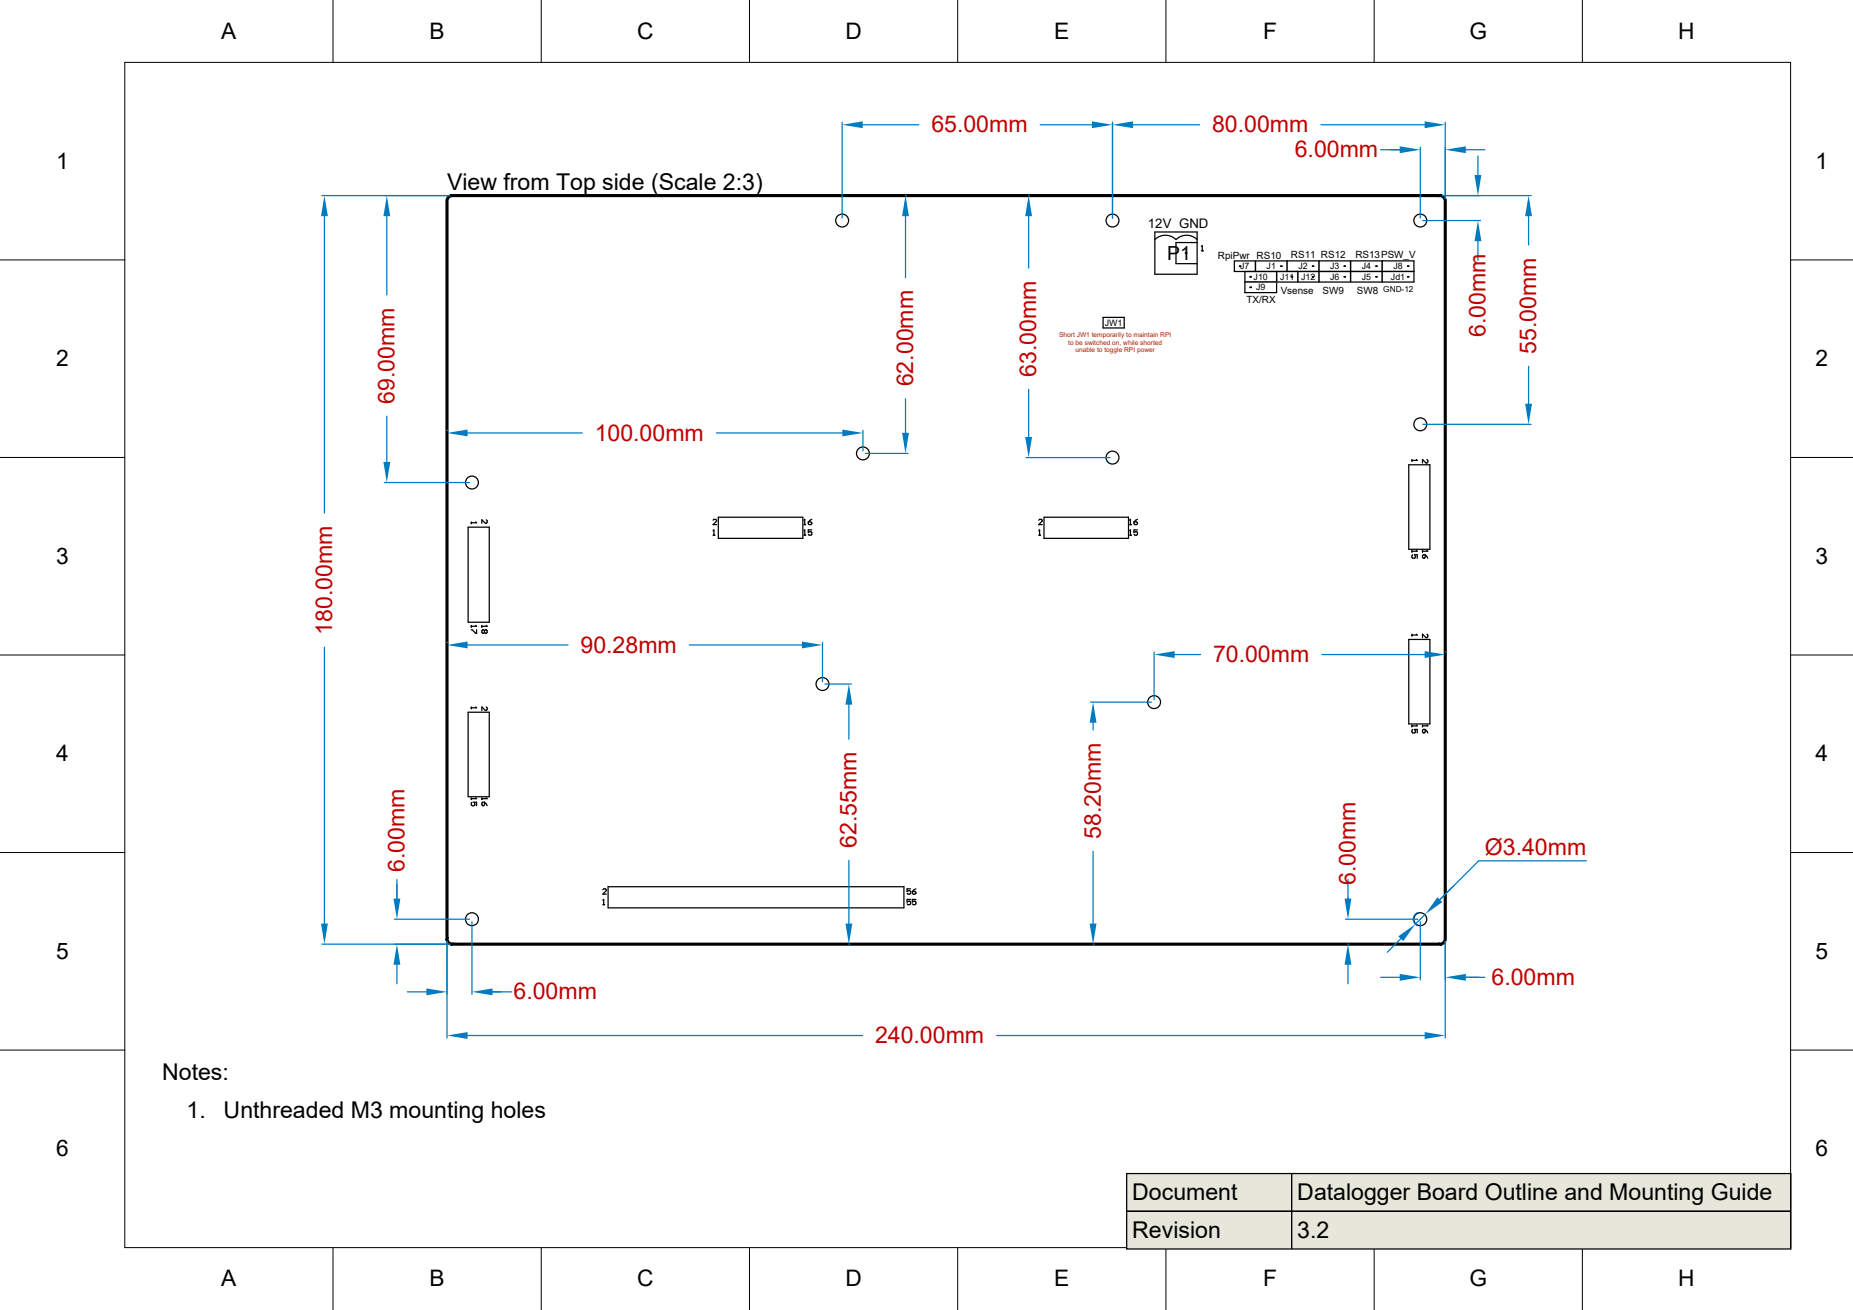
[picture p23: page 1]

View from Top side (Scale 2:3)

J1 | J2 | J3 | J4 | J8
J10 | J11 | J12 | J6 | J5 | Jd1

Short JW1 temporarily to maintain RPI
to be switched on, while shorted
unable to toggle RPI power

Datalogger Board Outline and Mounting Guide
