hydrogeologger/hardware-datalogger/(list of files, drawings)

Other design files:
Datalogger.PcbLib
Datalogger.SchLib
Project_ConnectorBoard/ConBoard_Top.SchDoc
Project_ConnectorBoard/DataLoggerV3.x_ConnBoard.PrjPCB
Project_ConnectorBoard/PCB1.PcbDoc
Project_ConnectorBoard/PCB2.PcbDoc
Project_ConnectorBoard/PCB3.PcbDoc
Project_Mainboard/5V_switches.SchDoc
Project_Mainboard/12V_5V_switches.SchDoc
Project_Mainboard/Arduino_schematics.SchDoc
Project_Mainboard/DataloggerV3.x_Mainboard.PrjPcb
Project_Mainboard/HS_Inverted-Normal_Switch_LOW_PWR.SchDoc
Project_Mainboard/HS_LS_switch_HI_PWR.SchDoc
Project_Mainboard/HS_LS_Switch_LOW_PWR.SchDoc
Project_Mainboard/Inverted_HS_LS_switch_HI_PWR.SchDoc
Project_Mainboard/Inverted_HS_switch_HI_PWR.SchDoc
Project_Mainboard/PCB4.PcbDoc
Project_Mainboard/pi_3.3v_5v_switches.SchDoc
Project_Mainboard/RPI_schematics.SchDoc
Project_Mainboard/Top level.SchDoc
