hydrogeologger/hardware-datalogger/(commit log)

2022-05-11 Initial Comit, v3.1.1
    Fixed parts schematic library source reference
    Changed source reference from Data_logger_v3.SchLib to Datalogger.SchLib
    Removed unnecessary mounting hole for U1
    [12V_5V_switches.SchDoc, 5V_switches.SchDoc, Arduino_schematics.SchDoc, BOM-Connboard.xlsx, BOM-Mainboard.xlsx, ConBoard_Top.SchDoc, DataLoggerV3.x_ConnBoard.PrjPCB, Datalogger.SchLib]
2022-05-11 python: Added switch_biasing.py
    * Added function to calculate NPN BJT Q-point and biasing resistor values
    * Added function to calculate P-Channel and N-Channel K parameter from datasheet
    * Added function to calculate MOSFET Saturation Voltage
    * Added function to calculate MOSFET Triode Q-Point
    * Added function to estimate theoretical load for desired current draw
    * Added function to estimate voltage drop over MOSFET
    python: Added DMC3016LSD parameters for calculation
    python: Rename file and tidied up code
2022-05-11 Added DMC2038 mosfet
    Added SOT23-6 (TSOT26) footprint
    [Datalogger.SchLib]
2022-05-11 Added digital pin# labels for Rx1-Rx3, Tx1- Tx3 on connector board
    [PCB3.PcbDoc]
2022-05-11 Added DMC3016 dual channel n-p fet and SOIC-8 footprint
    Modified MEGA2560PRO-MINI footprint, Added MEGA2560-PRO-MINI-IO footprint
    * Removed M22 Mechanical Layer
    * Renamed Analog pad designator to equivalent schematic symbol pin names
    * Renamed RX0 and TX0 pad designator to D0 and D1
    * Added MEGA2560-PRO-MINI-IO footprint which doesn't include mounting holes and programmer header pads
    [Datalogger.SchLib]
2022-05-11 Added mounting hole for DHT22 horizontal footprint
    [DataloggerV3.x_Mainboard.PrjPcb]
2022-05-11 python: Separated fet and bjt data and functions into own module
    python: Fix resistor select referencing variable before assignment
    * Fix resistor select referencing unassigned variable if resistor input was not in resistor array
    python: Major iteration of switches_biasing.py
    * Removed functions to separate module
    * Removed fet and bjt variables to separate module
    * Fixed ascii scematic and variable names
    * Tidied up formatting
    python: Added calculation for inverse switching calculation
    python: Rename files and Renamed bjt functions to npn
    Added high side switch bias calculation script
2022-05-11 Schematic reference fix, Implemented DMC3016 for external load switches
    * Modified all external load switches to use DMC3016 fets
    * Fixed schematic object references
    * Fixed schematic library "cap pol 1" footprint reference for CAP4X5
    Implemented DMC3016 FET
    * Converted C8 - C11 from through hole to smd footprint
    * Removed MH 8 and MH9 from PCB
    * Removed C16, C19 - C21 from pcb
    * Converted R8,9,11,12,17,18 to 0805 medium density footprint
    * Converted R16D and 16U to 1206-0805 compatible footprint
    * Stiched RPI Switches, Hi power and inverted ard switch
    * Revert resistor footprints back to 0805/1206 compatible footprint
    * Moved U2 further to the right to make room for larger resistor footpri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
    [Arduino_schematics.SchDoc, Datalogger.SchLib, DataloggerV3.x_Mainboard.PrjPcb, HS_Inverted-Normal_Switch_LOW_PWR.SchDoc, HS_LS_Switch_LOW_PWR.SchDoc, HS_LS_switch_HI_PWR.SchDoc, Inverted_HS_LS_switch_HI_PWR.SchDoc, Inverted_HS_switch_HI_PWR.SchDoc]
2022-05-11 Changed fet/bjt bias, pull up, pull down resistor values
    * Updated NPN Rb to 390k
    * Updated NPN Rc to 120k
    * Updated pullup and pulldown resistors of FETs to 120k
    [HS_Inverted-Normal_Switch_LOW_PWR.SchDoc, HS_LS_Switch_LOW_PWR.SchDoc, HS_LS_switch_HI_PWR.SchDoc, Inverted_HS_LS_switch_HI_PWR.SchDoc, Inverted_HS_switch_HI_PWR.SchDoc]
2022-05-11 Modified vsense and UART voltage divider resistors, TX/RX overlay fix
    Vsense
    R2: 2k -> 120k
    R3: 680 -> 39k
    Modified RPI <-> Arduino UART voltage divider resistor values
    R6: 1.8k -> 39k
    R5: 1k -> 22k
    R7: 330 -> 22k
    * Top overlay fix of Tx/Rx Descriptor, minor fix
    * Changed JW1 type from standard to standard (No BOM)
    * Changed 3.3V capacitor C31 from TH to SMD, 2.2uF -> 10uF
    [Arduino_schematics.SchDoc, Inverted_HS_switch_HI_PWR.SchDoc, Top level.SchDoc]
2022-05-11 Python: Minor fix to include collector current in npn bias calculation
    * Convert resistor values in voltage divider script to use SI units
    Python: Added secondary P-Fet to bias high side switch appropriately
    * Added P-Fet NTR1P02 / NVR1P02 parameters
2022-05-11 Implemented P-Fet to completely turn off inverted switch, version bump
    *Update revision number to 3.2
    * Placed and aligned components for ISA4.
    * VIA thermal design rule change and finish stitching FDV304P
    * Placement of thermal relief via's for inverted switches
    * Placement various vias on pcb
    * Various minor fixes with poygon nets
    * Provided more ground path solutions for RPI switches
    * Other various miror polygon and trace placement fixes
    * Changed FDV304P to NTR1P02
    * FDV304P has a Max Vgs of -8V.
    * NTR1P02 has a Max Vgs of -20V
    * 12V rail Reroute
    * Swapped locations of C5 and C4
    * Updated C5 7 C4 polygons
    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
    [ConBoard_Top.SchDoc, DataLoggerV3.x_ConnBoard.PrjPCB, DataloggerV3.x_Mainboard.PrjPcb, Inverted_HS_LS_switch_HI_PWR.SchDoc, PCB3.PcbDoc]
2022-05-11 Project admin update of python script and documents
    * Moved support folders to root folder
    * Updated schematic pdf and moved to doc folder
    * Added pinout and port mapping template to doc
    [Phoenix Plug Cost.xlsx, Template-PortMapping.xlsx]
2022-05-11 Moved DHT22_horizontal mechanical step projection from M1 to M13
    [DataloggerV3.x_Mainboard.PrjPcb]
2022-05-11 Project admin update
    * Removed PCB1.pcbdoc from mainboard project
    * Added Cam viewer file
    * Added board outline, drill guides to document folder
    * Renamed pcb3.pcbdwf -> BoardOutline.PCBDwf
    * Fixed PCB mounting hole drawings
    Updated production file and bom document
    [BOM-Connboard.xlsx, BOM-Mainboard.xlsx, DataLoggerV3.x_ConnBoard.PrjPCB, DataloggerV3.x_Mainboard.PrjPcb, Template-PortMapping.xlsx]
2022-08-25 v3.2.1 Hotfix
    * Version bump to 3.2.1
    * Updated BomDoc with additional alternate parts
    * Fixed incorrect silkscreen port description number of SD and SC ports in connector board
    * Display RPI secondary function for ISP and I2C on connector board silkscreen
    * Fixed placement of VIN and GND of U2 on main board silkscreen
    * Fixed placement of C* on main board silkscreen
    * Add duplicate revision number to main board
    * Modified R7, 22k -> 4k7 ohm
    * Modified R6, 39k -> 4k7 ohm
    * Modified R5, 22k -> 2k7 ohm
    * Syntax change for R1
    * Renamed and updated CAMTastic file
    [Arduino_schematics.SchDoc, DataLoggerV3.x_ConnBoard.PrjPCB, DataloggerV3.x_Mainboard.PrjPcb, PCB3.PcbDoc, Top level.SchDoc]
2022-08-25 Port map template minor fixes
    Added secondary functions for RPI pinouts
    Added secondary functions for analog ports
    [Template-PortMapping.xlsx]
2023-01-12 Added RPI, BPI-M2-Zero pinout cross compatibility
    [rpi-bpim2zero-pinout.xlsx]
2024-08-14 Small update
    * Staged harness files due to .gitattributes
    * Updated connector orientation in multiboard design schematic.
2024-08-15 Added new part to bom and updated footprint library
    * Added MEGA2560 Pro Mini Embed
    * Added ESQ-128-23-T-D part to bom
    [Datalogger.PcbLib, Datalogger.SchLib]
2024-08-15 Implement MEGA2560 Pro Embed on PCB
    [Arduino_schematics.SchDoc, DataloggerV3.x_Mainboard.PrjPcb, PCB4.PcbDoc]
2024-08-15 Added MKKDSN 3x2 and 2x2 part
    [Datalogger.PcbLib, Datalogger.SchLib]
2024-08-20 Updated connector boards to use 2x2 and 3x2 MKKDSN parts
    Bump revision to 3.2.1B
    [ConBoard_Top.SchDoc, DataLoggerV3.x_ConnBoard.PrjPCB, PCB3.PcbDoc]
2024-08-20 Embed I2C Multiplexer directly on board.
    [Arduino_schematics.SchDoc, PCB4.PcbDoc, Top level.SchDoc]
2024-08-20 Updated multiboard design and bom
2024-08-20 Fix design rules
    [PCB4.PcbDoc]
2024-08-28 DFA Report Fix
    * Plug-In increased hole size from 1.27mm to 1.5mm
    * Header pins increase hole size from 0.9mm to 1mm
    * Removed C28 from variation managed part
    [Arduino_schematics.SchDoc, Datalogger.PcbLib, DataloggerV3.x_Mainboard.PrjPcb, PCB4.PcbDoc, Top level.SchDoc]
2026-08-21 Remove local resource reference and use relative path
    [DataLoggerV3.x_ConnBoard.PrjPCB, DataloggerV3.x_Mainboard.PrjPcb]
2026-08-21 Revert revision number for connboard
    [DataLoggerV3.x_ConnBoard.PrjPCB]
2026-08-21 Added output jobs and removed cam files
    Updated .PrjPcb files with new parameters
    [DataLoggerV3.x_ConnBoard.PrjPCB, DataloggerV3.x_Mainboard.PrjPcb]
2026-09-04 Replaced TEl15-1211 due to component eol
    Removed stray Via's by C28
    Removed superfluous Via adjacent to R22
    [Datalogger.PcbLib, Datalogger.SchLib, PCB4.PcbDoc, Top level.SchDoc]
2026-09-04 Board layer number and type refactoring
    Update layer number types
    Added imperial 0805 chip footprint.
    Added CR2032 coin cell holder footprint to pcblib.
    Added FP-PW0024A-MFG TSSOP-24
    Use local symbols and footprint for TCA9548APWR
    [Datalogger.PcbLib, Datalogger.SchLib, PCB3.PcbDoc, PCB4.PcbDoc, Top level.SchDoc]
2026-09-04 Added and implemented RTC and CR2032
    [Datalogger.PcbLib, PCB4.PcbDoc, RPI_schematics.SchDoc]
2026-09-04 Bump mainboard version to 3.3.0
    [DataloggerV3.x_Mainboard.PrjPcb]
